aasanchez/Trabajo-de-Grado/Eagle/TG-Final/Diseño.png

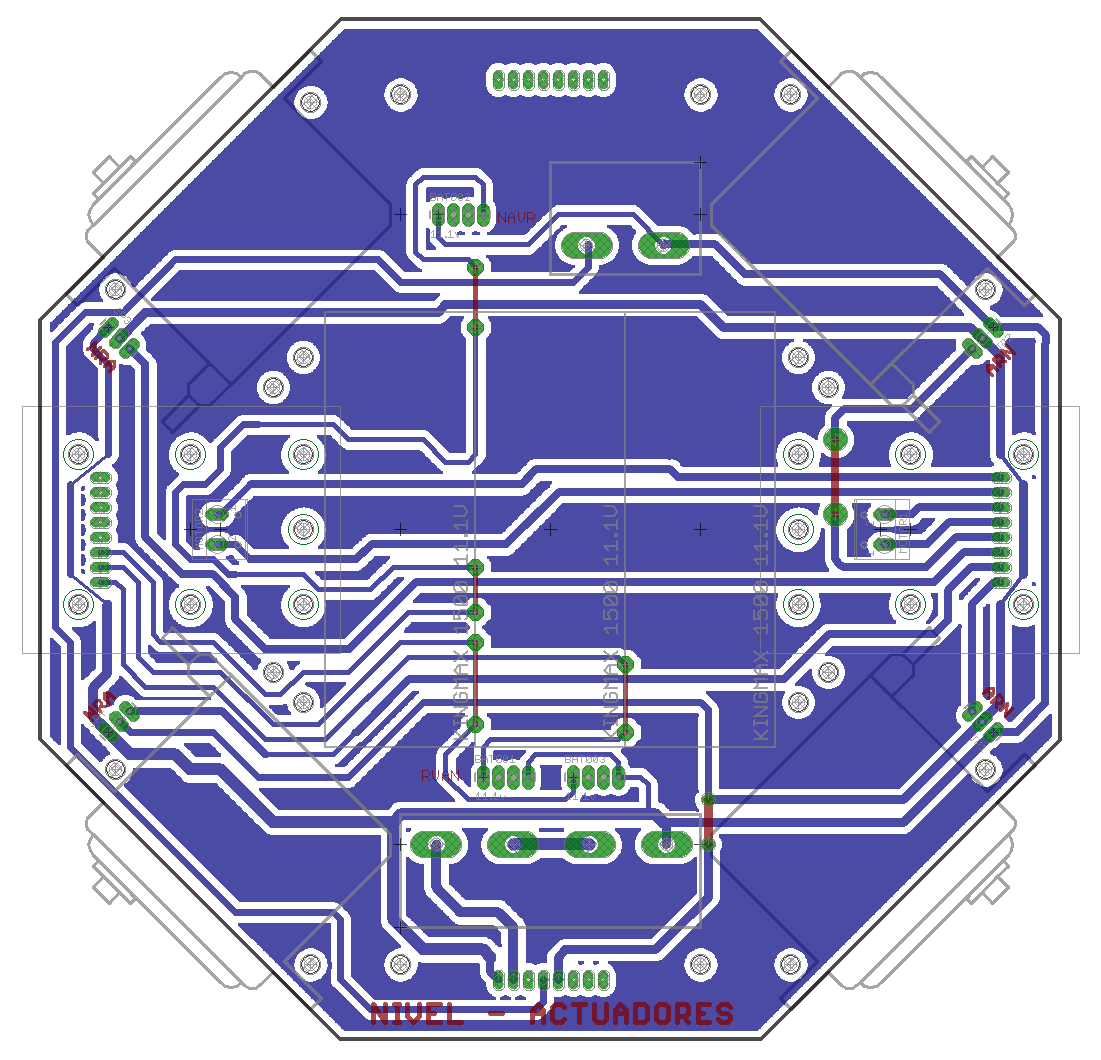
Eagle/TG-Final/Diseño.png
