aasanchez/Trabajo-de-Grado/Libro/Diagramas/Diagrama de Procesos.png

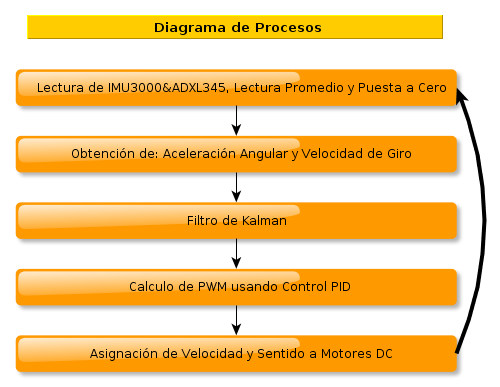
Libro/Diagramas/Diagrama de Procesos.png
