aasanchez/Trabajo-de-Grado/Libro/Diagramas/Procesos-002 (Adquisicion, puesta a 0 y calculo de Angulo).png

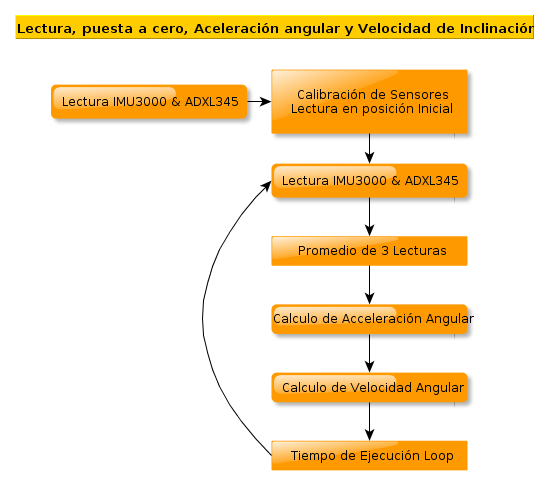
Libro/Diagramas/Procesos-002 (Adquisicion, puesta a 0 y calculo de Angulo).png
