aasanchez/Trabajo-de-Grado/Libro/RevisionDocumental/acceleraciones.png

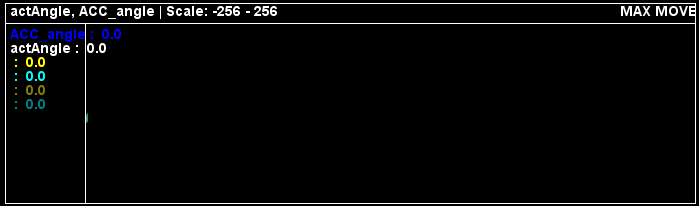
Libro/RevisionDocumental/acceleraciones.png
