aasanchez/Trabajo-de-Grado/Libro/RevisionDocumental/error.png

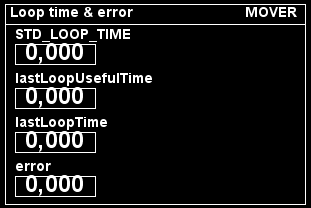
Libro/RevisionDocumental/error.png
