aasanchez/Trabajo-de-Grado/Libro/RevisionDocumental/graficadorusb.png

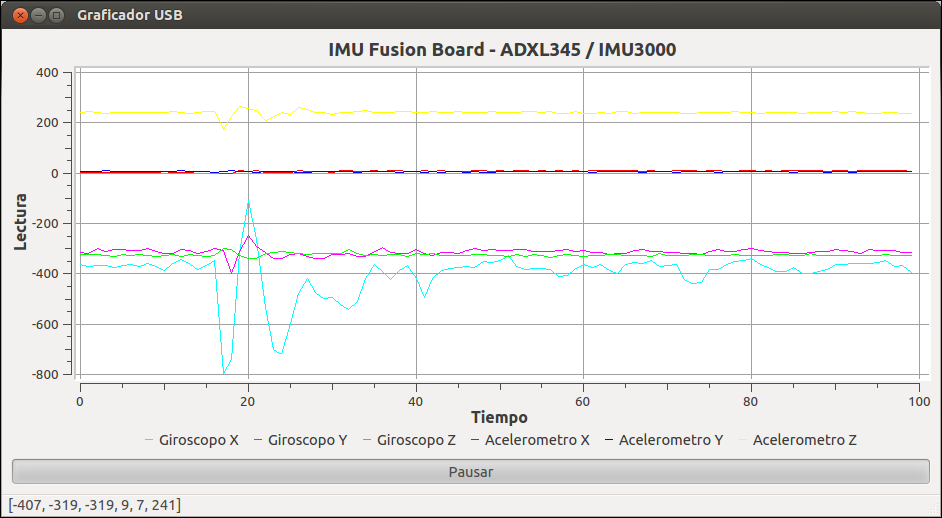
Libro/RevisionDocumental/graficadorusb.png
