aasanchez/Trabajo-de-Grado/Libro/RevisionDocumental/Gyroscope-9-4.png

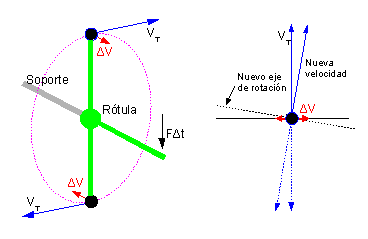
Libro/RevisionDocumental/Gyroscope-9-4.png
