aasanchez/Trabajo-de-Grado/Libro/RevisionDocumental/l298.bmp

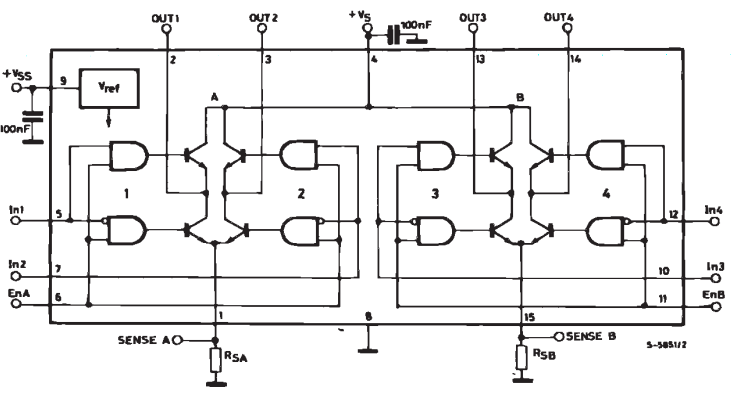
Libro/RevisionDocumental/l298.bmp
