aasanchez/Trabajo-de-Grado/Libro/RevisionDocumental/l298_pl.jpg

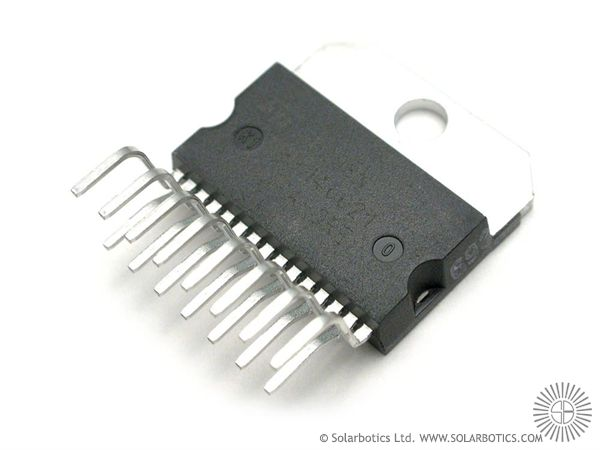
Libro/RevisionDocumental/l298_pl.jpg
