aasanchez/Trabajo-de-Grado/Libro/RevisionDocumental/lectura IMU.png

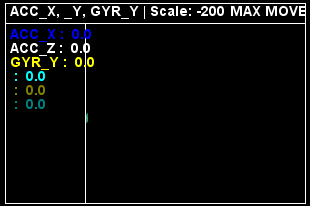
Libro/RevisionDocumental/lectura IMU.png
