aasanchez/Trabajo-de-Grado/Libro/RevisionDocumental/motores.png

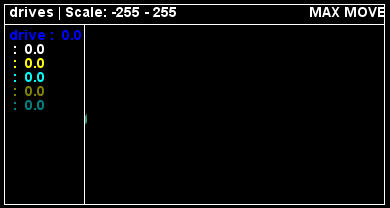
Libro/RevisionDocumental/motores.png
