aasanchez/Trabajo-de-Grado/Libro/RevisionDocumental/pid.png

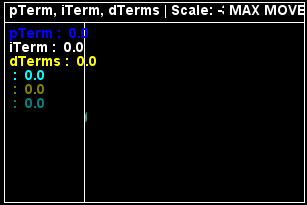
Libro/RevisionDocumental/pid.png
