aasanchez/Trabajo-de-Grado/Pruebas/lipomonitor/main.rtf

Software Development Document

for

%PROJECTTITLE%

Prepared by: %DEVELOPER%

%COMPANY%

Table of Contents

1.Scope
1.1 Identification
The formal name for this project is: %PROJECTTITLE%
The electronic name is: main
Date when project was created:%DATE_CREATED%
Dates when changes were made: %CHANGES%

1.2 Purpose
%PURPOSE%
1.3 Introduction
This document describes the detailed design for this project.

2. Referenced Documents
2.1 Related Documentation
%REFERENCES%

2.2 Project Source Files

main.c
..\..\..\..\Program Files\PICC\devices\16F88.H

2.3 Project Output File
main.err
main.esym
main.hex
main.sym
main.lst
main.cof
main.PJT
main.tre
main.sta

3. Requirements
3.1 Program Overview
%OVERVIEW%

3.2 Global Data
3.2.1 Constants

Identifier | Type | Description
__PCM__ | 4.114
__DEVICE__ | 88
__DATE__ | 15-feb-12
__TIME__ | 15:51:11 | Standard Header file for the PIC16F88 device ////////////////

3.2.2 Types
Identifier | Type | Description

3.2.3 Variables

Identifier | Type | Description
valor | int8

3.3 Detailed Design

3.3.1 main
3.3.1.1 Requirements

Author: %AUTHOR%
Purpose: %PURPOSE%
Date Created:%DATE_CREATED%
Changes:%CHANGES%

3.3.1.2 Local Data

Identifier | Type | Description

3.3.1.3 Local Constants

Identifier | Type | Description

3.3.1.4 Local Types

Identifier | Type | Description

4.0 Functions

Function Name | Description
main
