aasanchez/Trabajo-de-Grado/Libro/pruebas/Aceleracion Angular.png

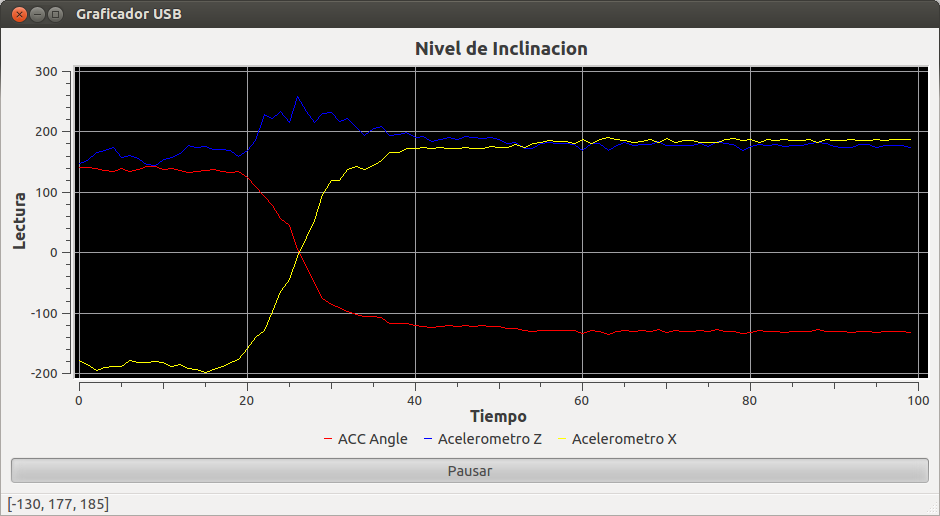
Libro/pruebas/Aceleracion Angular.png
