aasanchez/Trabajo-de-Grado/Libro/pruebas/tip42.png

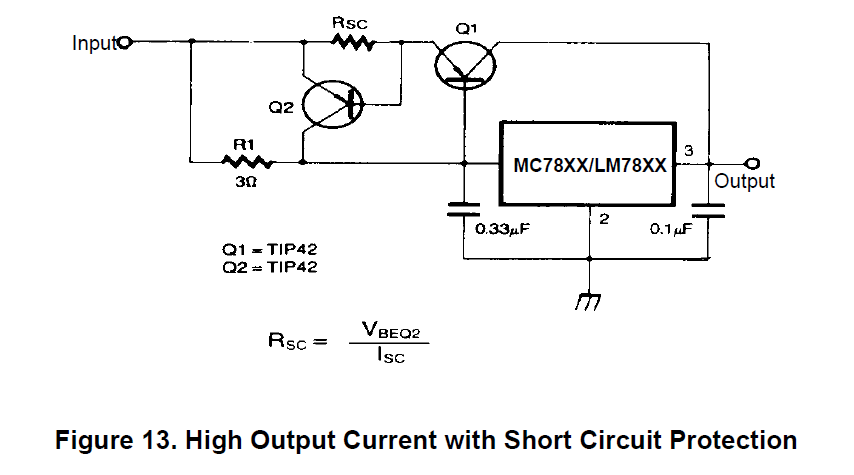
Libro/pruebas/tip42.png
