aasanchez/Trabajo-de-Grado/Pruebas/Imagenes de Apoyo/7805_a_5amp_212.jpg

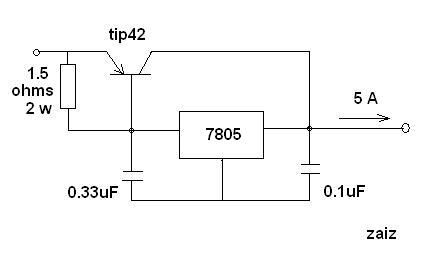
Pruebas/Imagenes de Apoyo/7805_a_5amp_212.jpg
