aasanchez/Trabajo-de-Grado/Pruebas/Imagenes de Apoyo/fuente_5v_848.gif

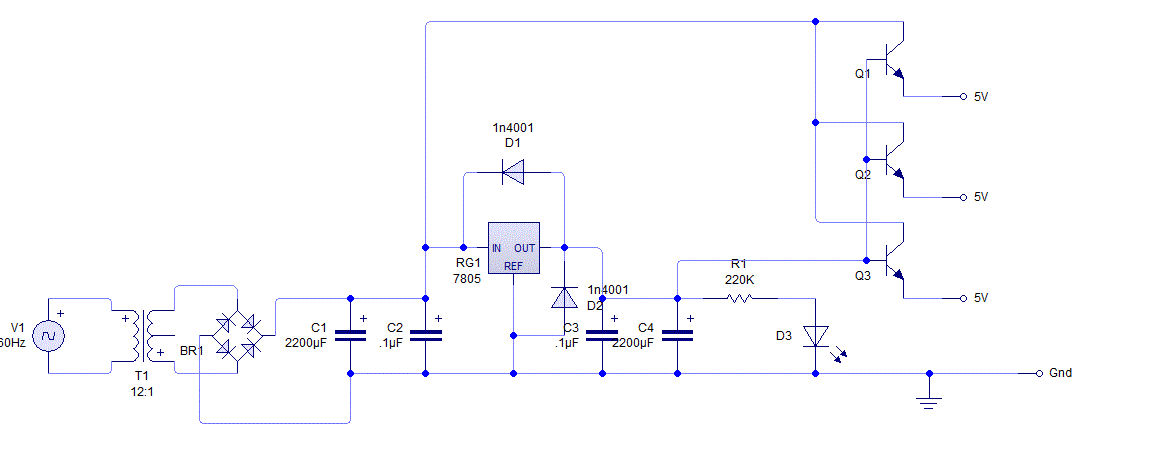
Pruebas/Imagenes de Apoyo/fuente_5v_848.gif
