aasanchez/Trabajo-de-Grado/Pruebas/Imagenes de Apoyo/fuente_5v_version2_129.gif

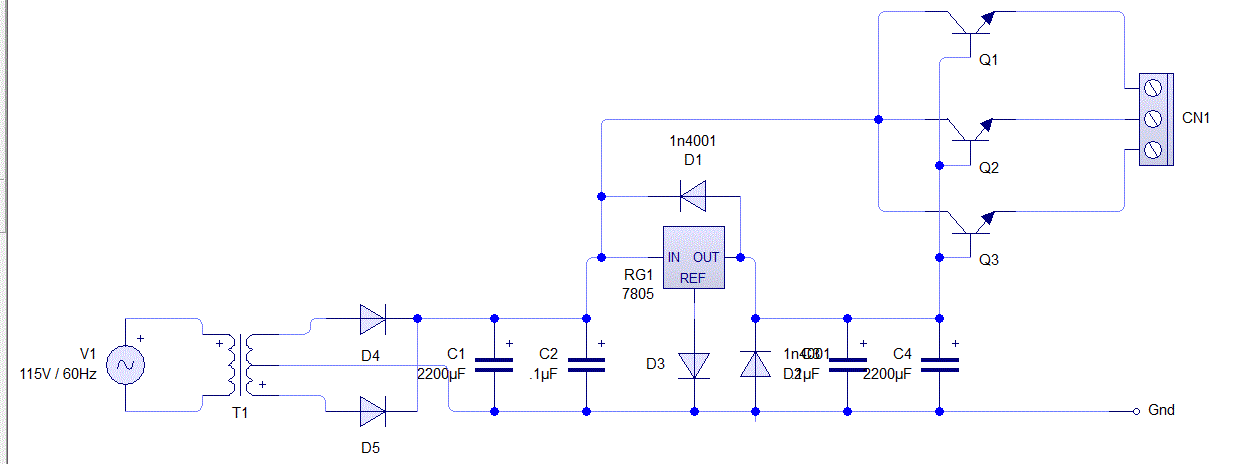
Pruebas/Imagenes de Apoyo/fuente_5v_version2_129.gif
