aasanchez/Trabajo-de-Grado/Pruebas/Imagenes de Apoyo/regulador1_195.pdf

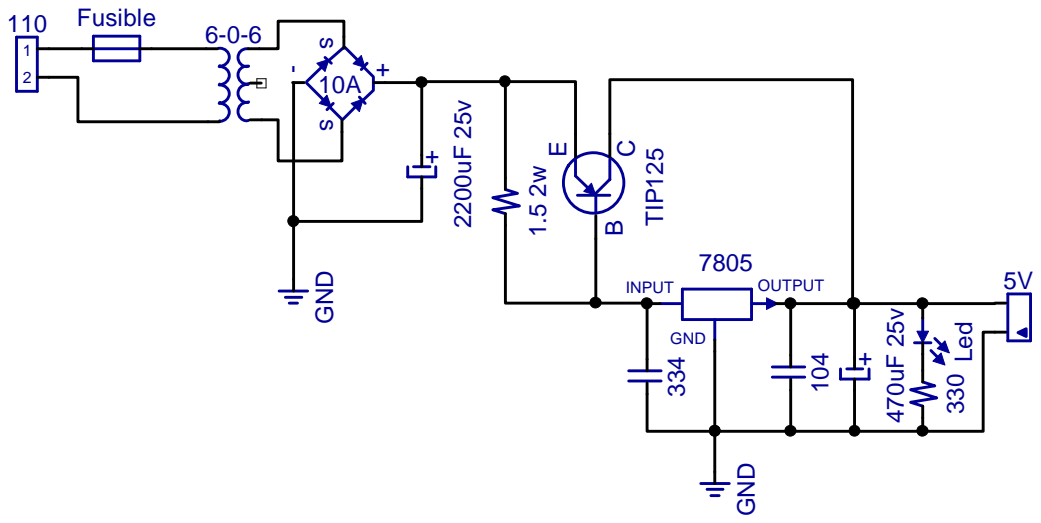
[picture p71: page 1]
GND; Fusible; Led; TIP125; INPUT; OUTPUT
