aasanchez/Trabajo-de-Grado/Eagle/TG-Final/bluesmirf.pdf

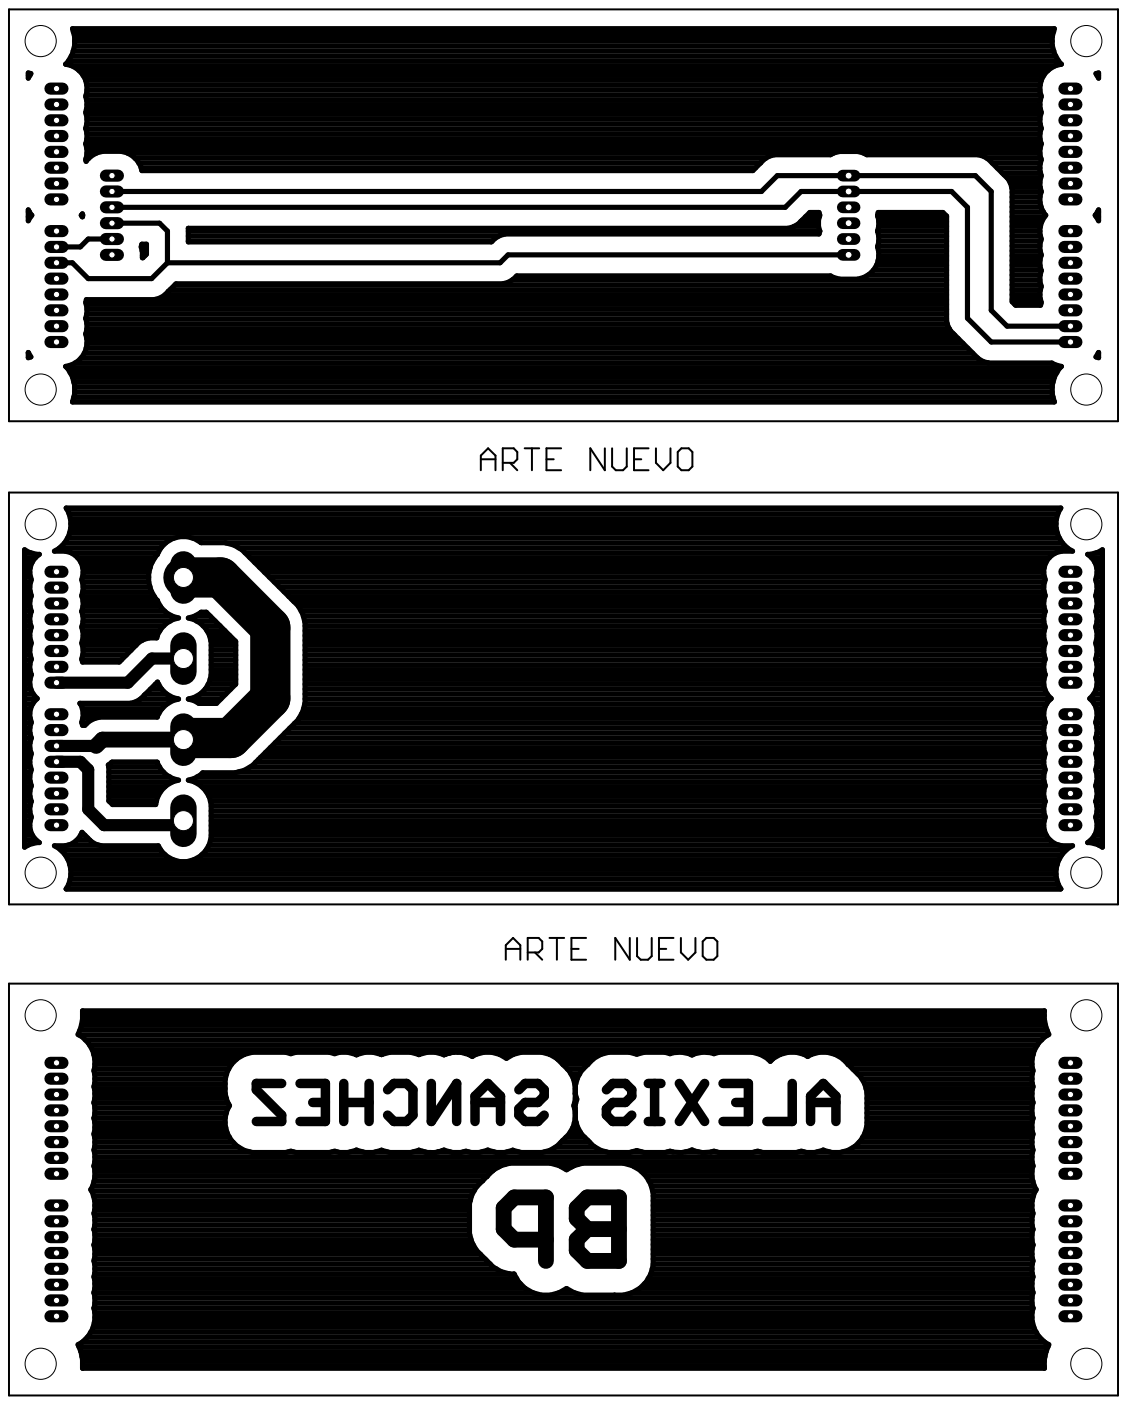
[picture p72: page 1]
