aasanchez/Trabajo-de-Grado/Eagle/TG-Final/control-silkcreen.pdf

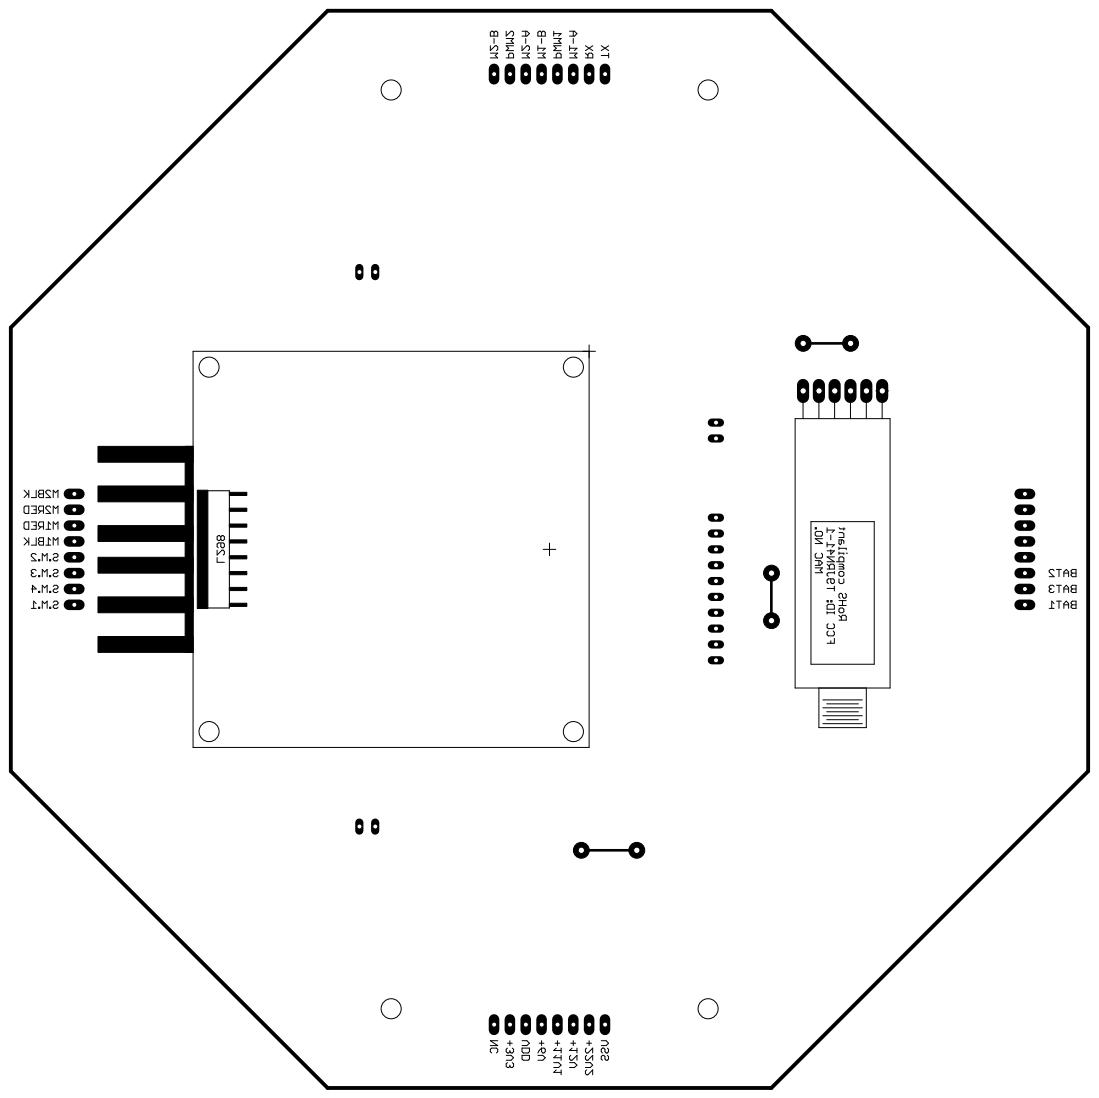
[picture p73: page 1]
