aasanchez/Trabajo-de-Grado/Eagle/TG-Final/energia.pdf

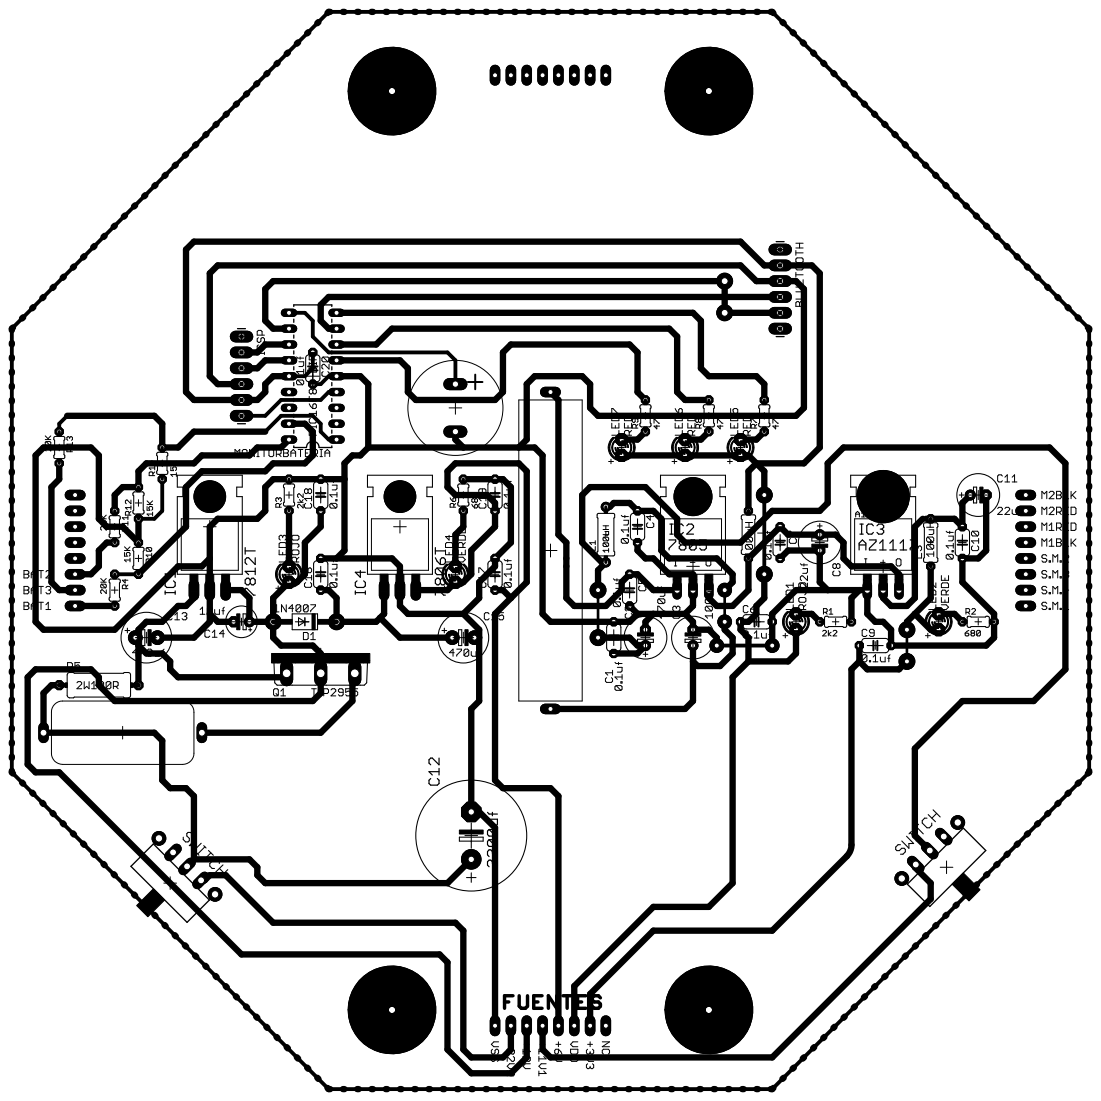
[picture p74: page 1]
