aasanchez/Trabajo-de-Grado/Eagle/TG-Final/nivel0.pdf

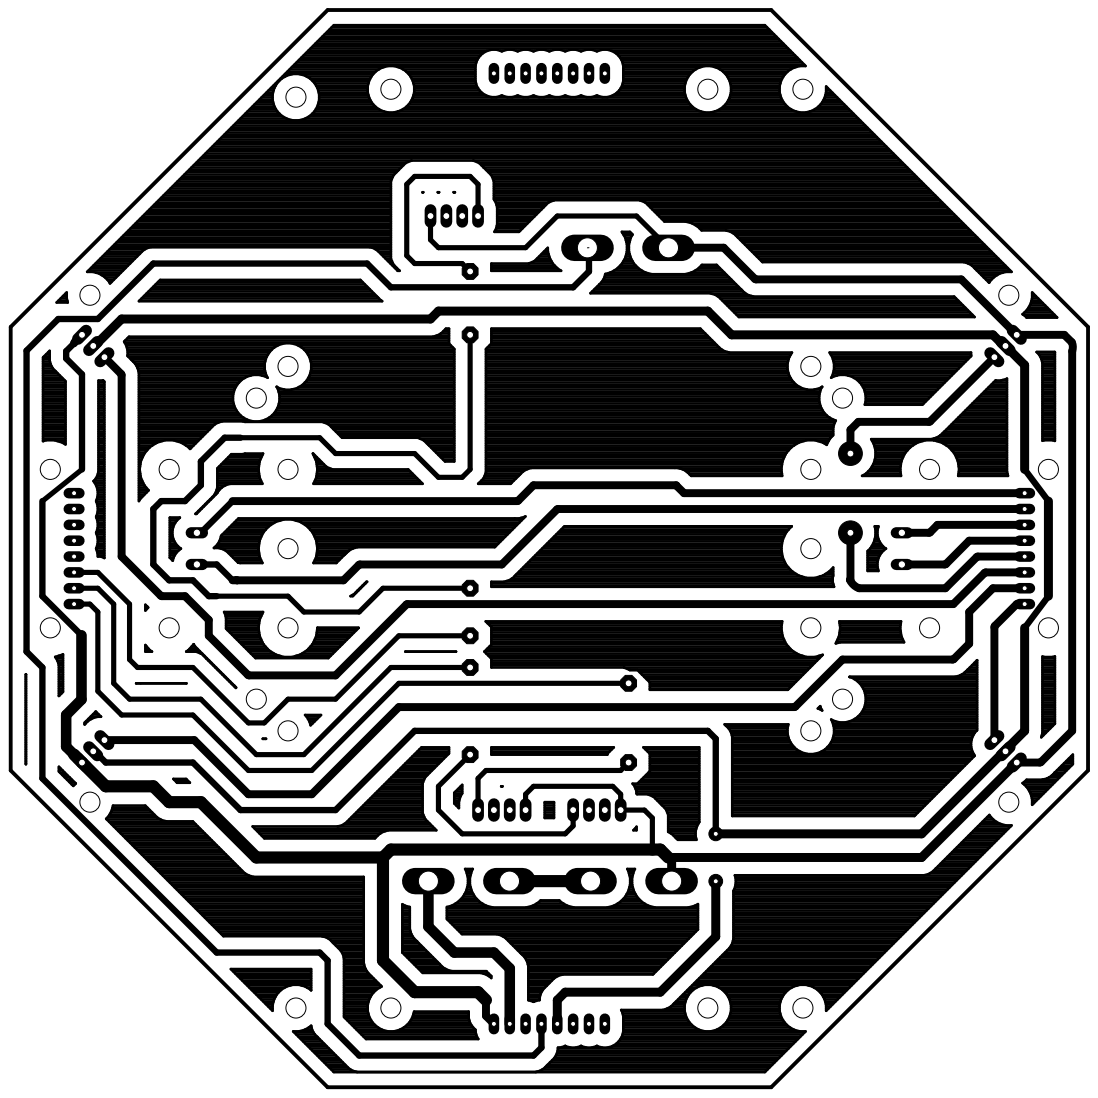
[picture p75: page 1]
