aasanchez/Trabajo-de-Grado/Eagle/TG-Final/nivel0-silkcreen.pdf

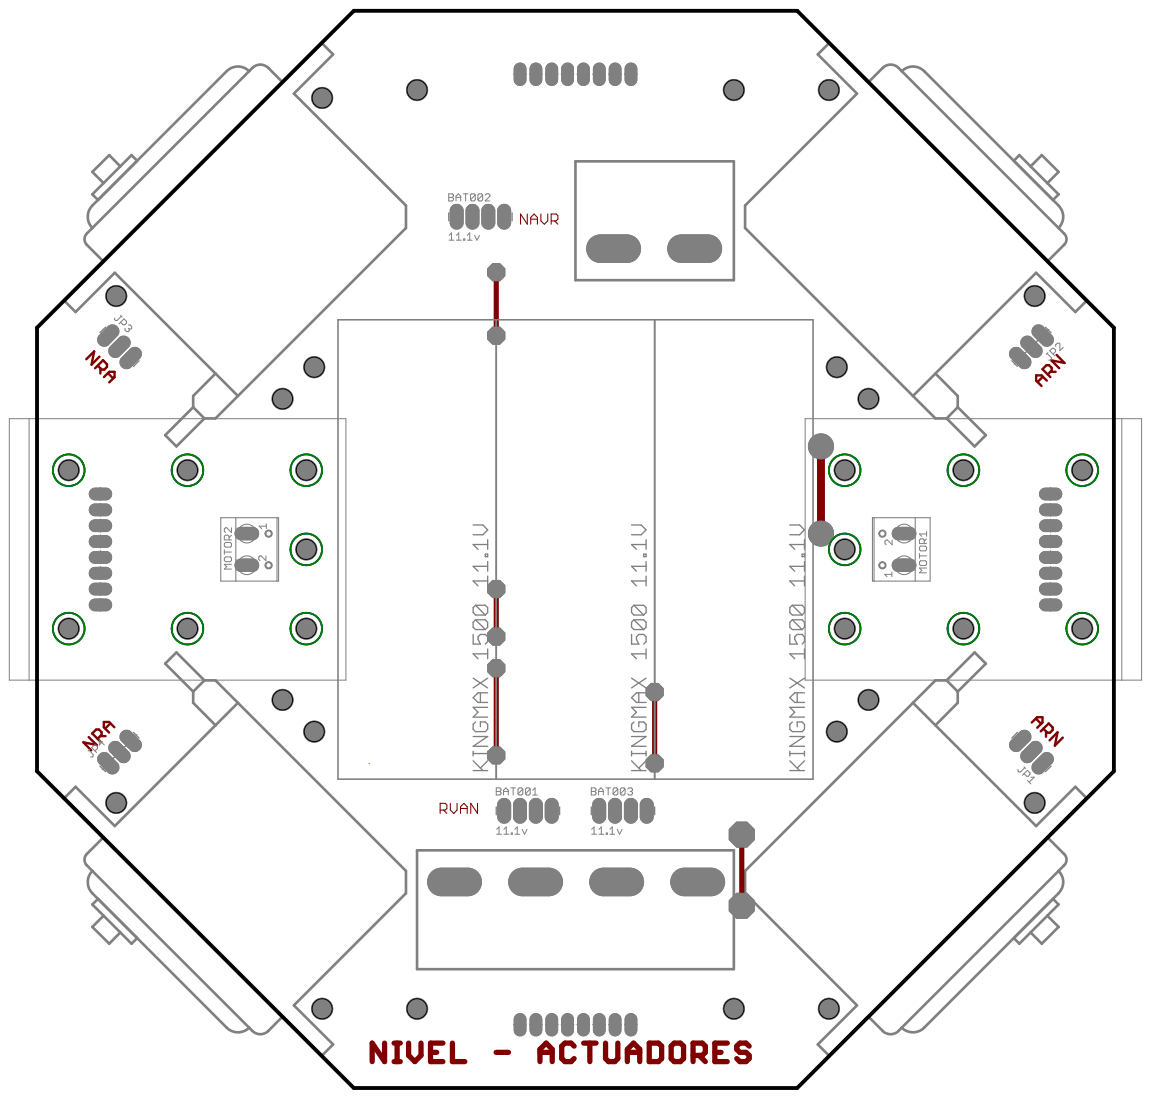
[picture p76: page 1]
