aasanchez/Trabajo-de-Grado/(list of files, drawings)

Other design files:
Libro/Diagramas/Esquematico.fzz
Pruebas/16f88/simulador.DSN
Pruebas/Barrido leds/simulador.DSN
Pruebas/lipomonitor/simulador.DSN
