aasanchez/Trabajo-de-Grado/Eagle/TG-Final/Motores.brd

## EAGLE design Eagle/TG-Final/Motores.brd (2012-04-23)

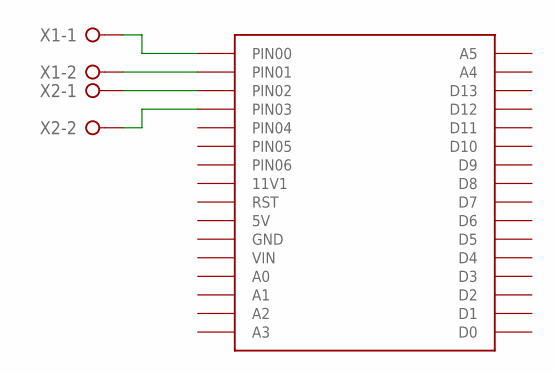
[picture p77: schematic Motores.sch]

Parts:
U$1: BASE-FINAL
X1, X2: W237-02P; W237-132

Connections:
unnamed: U$1.PIN01, X1.2
unnamed: U$1.PIN02, X2.1
unnamed: U$1.PIN03, X2.2
unnamed: U$1.PIN00, X1.1

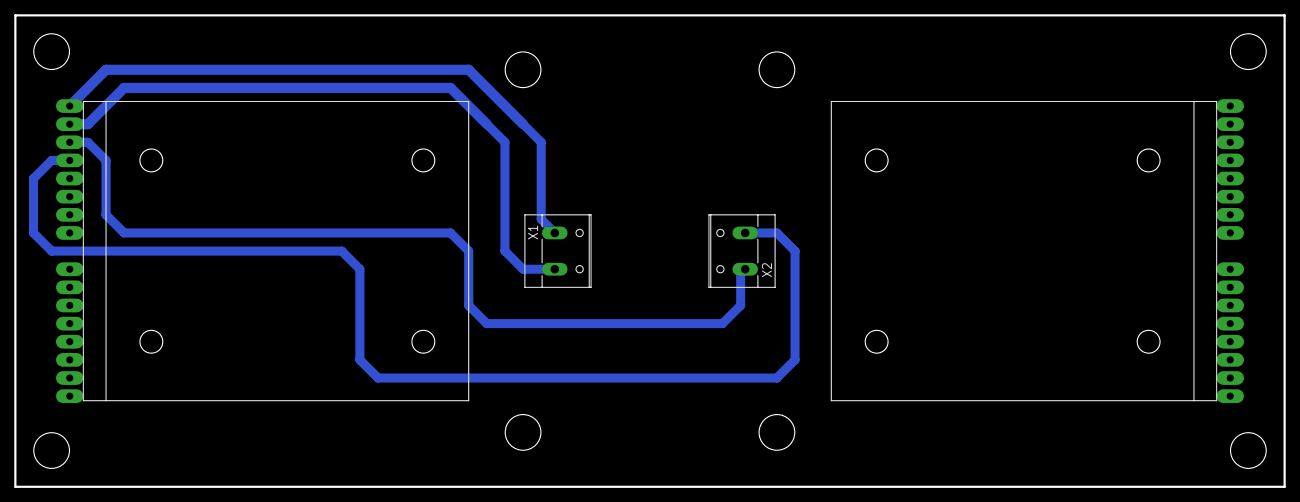
[picture p78: board Motores.brd from above]

Board: 2 copper layers, 177.8 x 66.0 mm, 5 parts (0 on the bottom side), 4 nets.

Other parts of the board:
U$2, U$3: BASEMOTOR
