aasanchez/Trabajo-de-Grado/Eagle/TG-Final/arduino.brd

## EAGLE design Eagle/TG-Final/arduino.brd (2012-04-23)

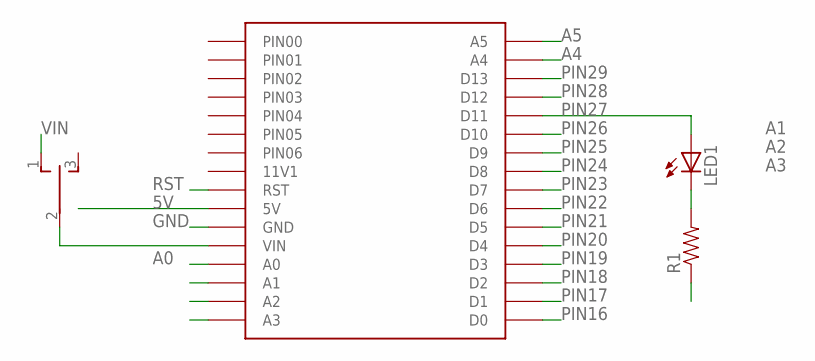
[picture p79: schematic arduino.sch, sheet 1]

Parts:
LED1: LED3MM
R1: RESISTORKIT; AXIAL-0.3-KIT
S2: TL39YOSWITCH_2_ESTADOS; TL3XYO
U$1: BASE-FINAL

Connections:
5V: U$1.5V; also elsewhere on the board
A0: U$1.A0; also elsewhere on the board
A1: U$1.A1; also elsewhere on the board
A2: U$1.A2; also elsewhere on the board
A3: U$1.A3; also elsewhere on the board
A4: U$1.A4; also elsewhere on the board
A5: U$1.A5; also elsewhere on the board
GND: R1.P$1 (1), U$1.GND; also elsewhere on the board
unnamed: S2.2, U$1.VIN
unnamed: LED1.K (C), R1.P$2 (2)
PIN16: U$1.0 (D0); also elsewhere on the board
PIN17: U$1.1 (D1); also elsewhere on the board
PIN18: U$1.2 (D2); also elsewhere on the board
PIN19: U$1.3 (D3); also elsewhere on the board
PIN20: U$1.4 (D4); also elsewhere on the board
PIN21: U$1.5 (D5); also elsewhere on the board
PIN22: U$1.6 (D6); also elsewhere on the board
PIN23: U$1.7 (D7); also elsewhere on the board
PIN24: U$1.8 (D8); also elsewhere on the board
PIN25: U$1.9 (D9); also elsewhere on the board
PIN26: U$1.10 (D10); also elsewhere on the board
PIN27: LED1.A, U$1.11 (D11); also elsewhere on the board
PIN28: U$1.12 (D12); also elsewhere on the board
PIN29: U$1.13 (D13); also elsewhere on the board
RST: U$1.RST; also elsewhere on the board
VIN: S2.1 (O); also elsewhere on the board

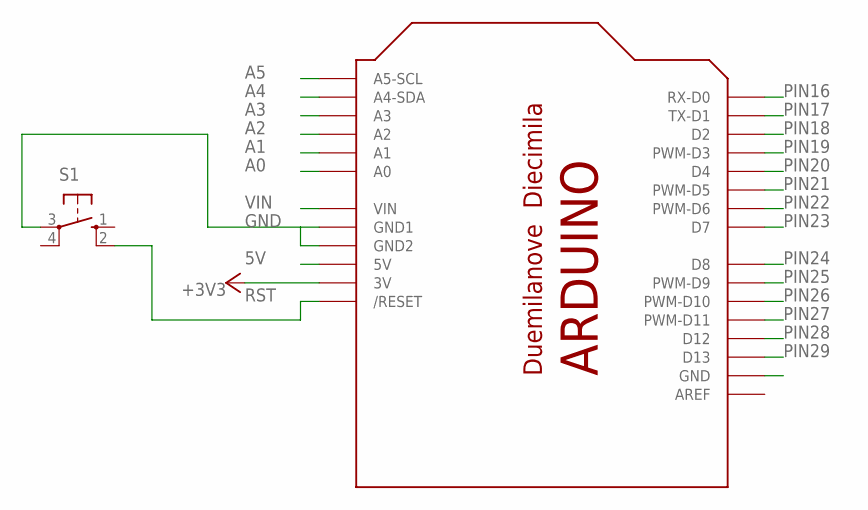
[picture p80: schematic arduino.sch, sheet 2]

Parts:
S1: 10-XX; B3F-10XX
U$6: ARDUINO-NOHOLE

Connections:
5V: U$6.5V; also elsewhere on the board
+3V3: U$6.3V; also elsewhere on the board
A0: U$6.A0; also elsewhere on the board
A1: U$6.A1; also elsewhere on the board
A2: U$6.A2; also elsewhere on the board
A3: U$6.A3; also elsewhere on the board
A4: U$6.A4 (A4-SDA); also elsewhere on the board
A5: U$6.A5 (A5-SCL); also elsewhere on the board
GND: S1.3, U$6.GND, U$6.GND1, U$6.GND2; also elsewhere on the board
PIN16: U$6.D0 (RX-D0); also elsewhere on the board
PIN17: U$6.D1 (TX-D1); also elsewhere on the board
PIN18: U$6.D2; also elsewhere on the board
PIN19: U$6.D3 (PWM-D3); also elsewhere on the board
PIN20: U$6.D4; also elsewhere on the board
PIN21: U$6.D5 (PWM-D5); also elsewhere on the board
PIN22: U$6.D6 (PWM-D6); also elsewhere on the board
PIN23: U$6.D7; also elsewhere on the board
PIN24: U$6.D8; also elsewhere on the board
PIN25: U$6.D9 (PWM-D9); also elsewhere on the board
PIN26: U$6.D10 (PWM-D10); also elsewhere on the board
PIN27: U$6.D11 (PWM-D11); also elsewhere on the board
PIN28: U$6.D12; also elsewhere on the board
PIN29: U$6.D13; also elsewhere on the board
RST: S1.2 (S1), U$6.RESET (/RESET); also elsewhere on the board
VIN: U$6.VIN; also elsewhere on the board

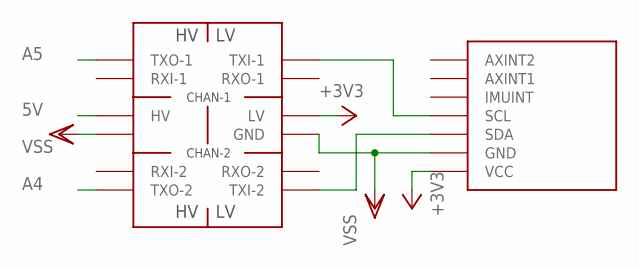
[picture p81: schematic arduino.sch, sheet 3]

Parts:
U$7: IMU3000COMBO; IMU3000-COMBO
U$8: LOGIC-LEVEL-CONVERTER; LEVEL-CONVERTER

Connections:
5V: U$8.P$10 (HV); also elsewhere on the board
+3V3: U$7.3V3 (VCC), U$8.P$3 (LV); also elsewhere on the board
A4: U$8.P$7 (TXO-2); also elsewhere on the board
A5: U$8.P$12 (TXO-1); also elsewhere on the board
GND: U$7.VSS (GND), U$8.P$4 (GND), U$8.P$9; also elsewhere on the board
unnamed: U$7.SCL, U$8.P$1 (TXI-1)
unnamed: U$7.SDA, U$8.P$6 (TXI-2)

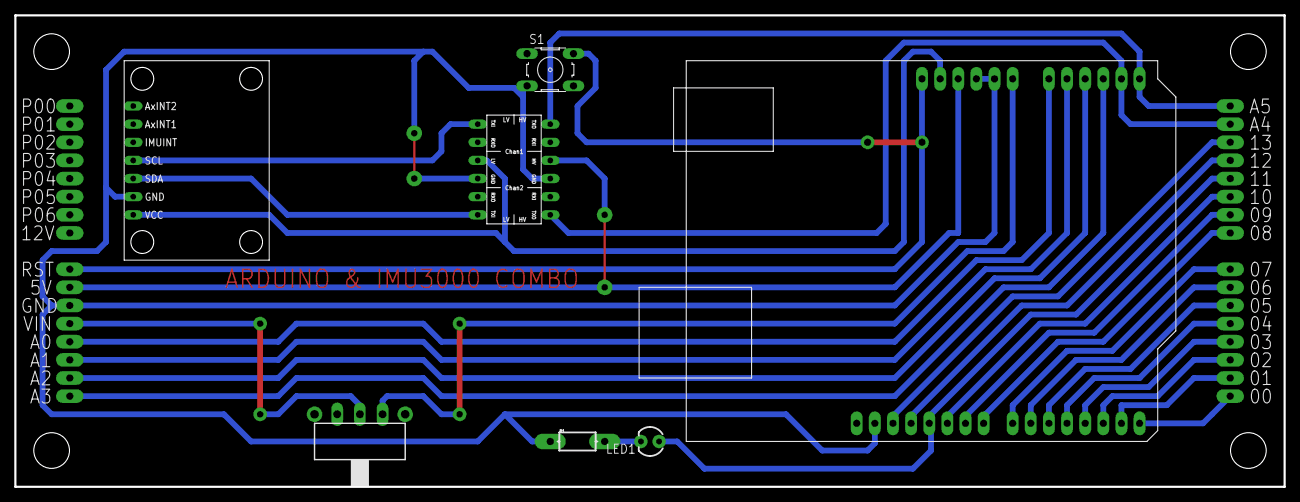
[picture p82: board arduino.brd from above]

Board: 2 copper layers, 177.8 x 66.0 mm, 8 parts (1 on the bottom side), 29 nets.
