aasanchez/Trabajo-de-Grado/Eagle/TG-Final/bluesmirf.brd

## EAGLE design Eagle/TG-Final/bluesmirf.brd (2012-04-23)

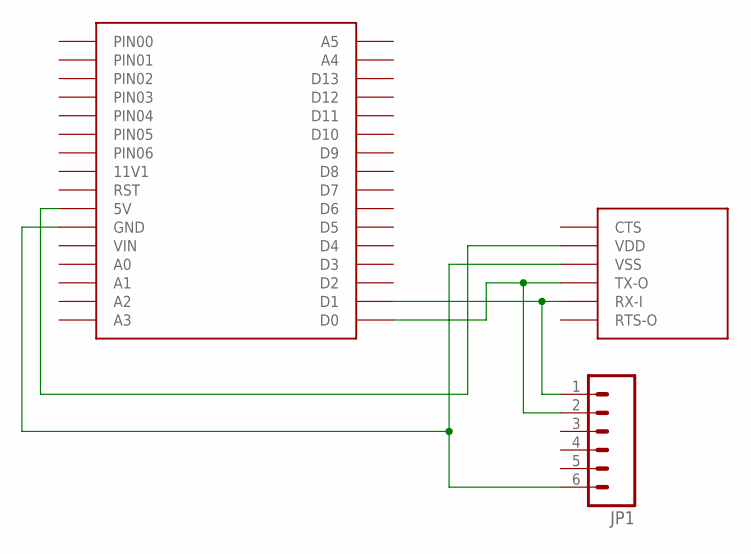
[picture p83: schematic bluesmirf.sch, sheet 1]

Parts:
JP1: M06LONGPADS; 1X06_LONGPADS
U$1: BASE-FINAL
U$2: BLUESMIRF

Connections:
unnamed: U$1.5V, U$2.VDD
unnamed: JP1.6, U$1.GND, U$2.VSS
unnamed: JP1.2, U$1.0 (D0), U$2.TX-O
unnamed: JP1.1, U$1.1 (D1), U$2.RX-I

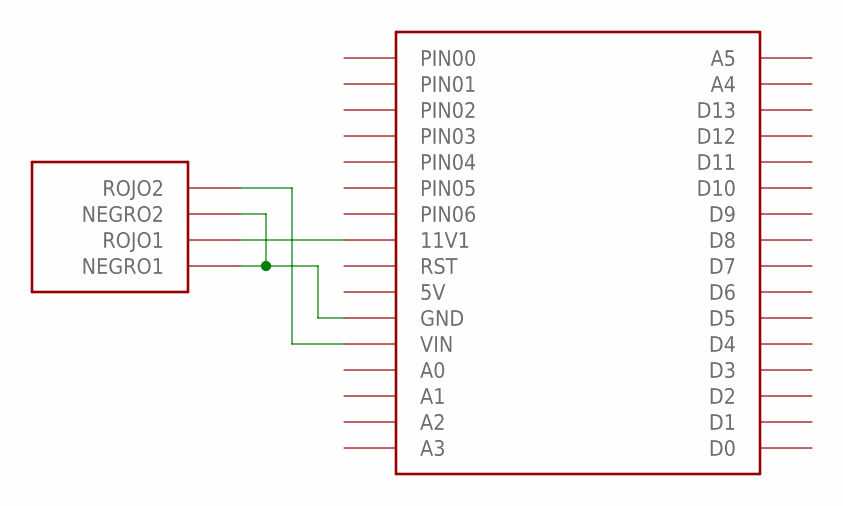
[picture p84: schematic bluesmirf.sch, sheet 2]

Parts:
U$3: BASE-FINAL
U$4: CONECTOR_AUDIO

Connections:
unnamed: U$3.GND, U$4.NEGRO1, U$4.NEGRO2
unnamed: U$3.12V (11V1), U$4.ROJO1
unnamed: U$3.VIN, U$4.ROJO2

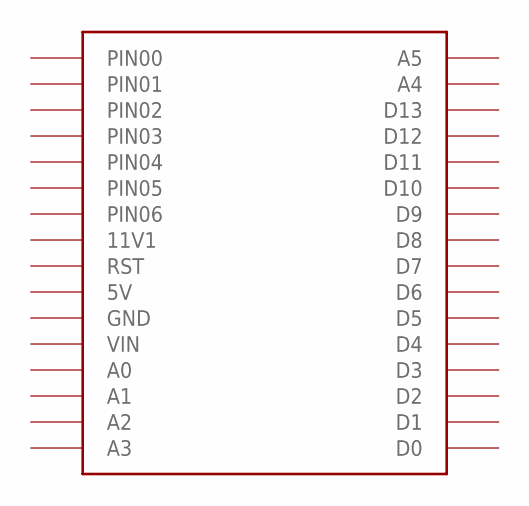
[picture p85: schematic bluesmirf.sch, sheet 3]

Parts:
U$7: BASE-FINAL

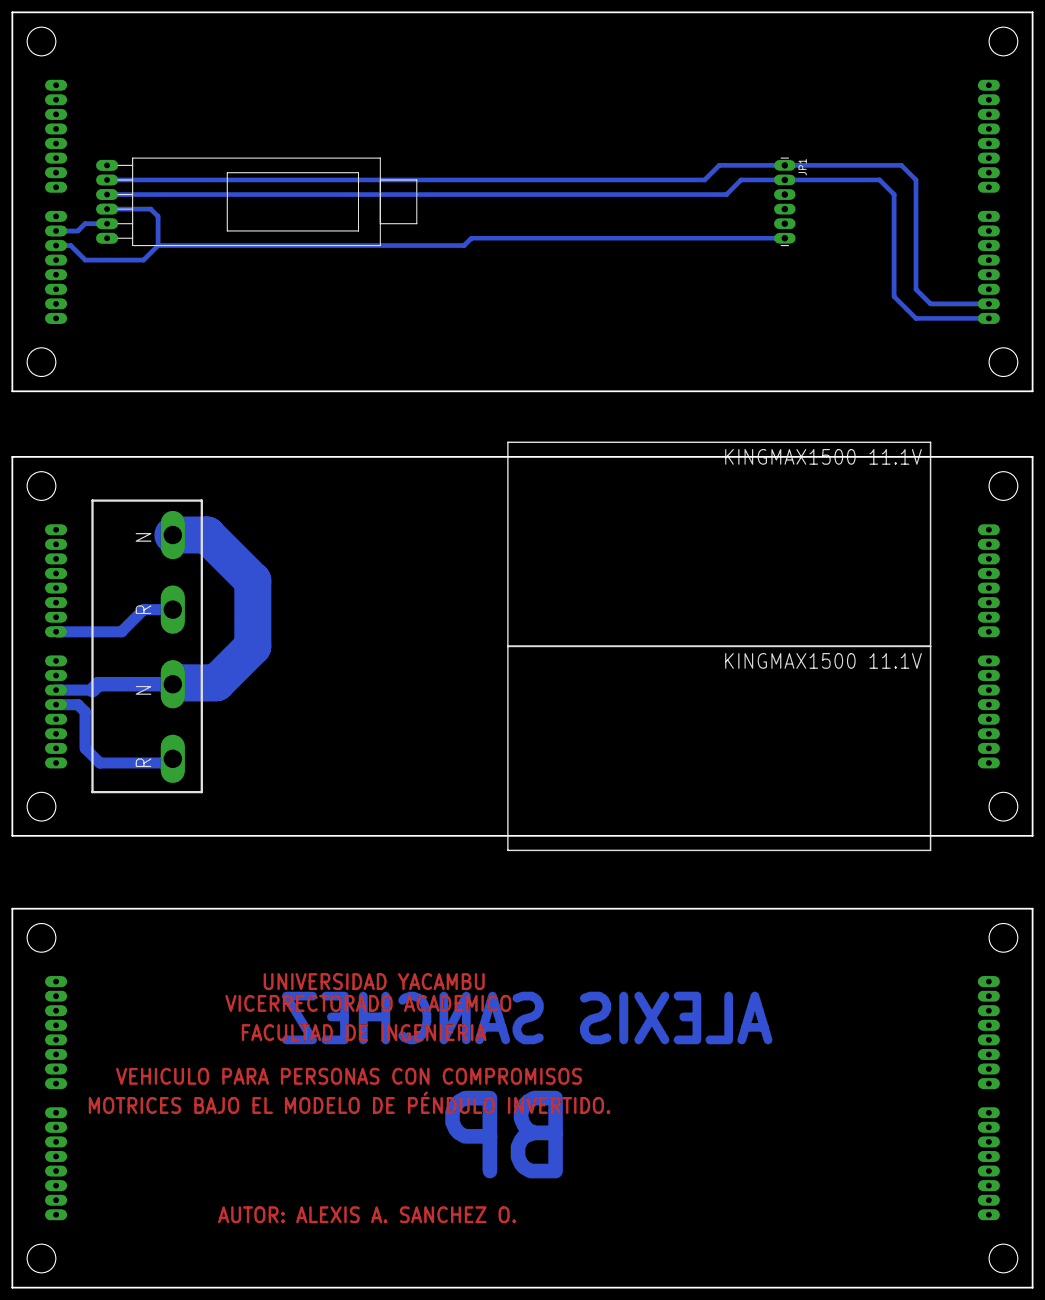
[picture p86: board bluesmirf.brd from above]

Board: 2 copper layers, 177.8 x 222.2 mm, 8 parts (0 on the bottom side), 7 nets.

Other parts of the board:
U$5, U$6: KINGMAX1500H
