aasanchez/Trabajo-de-Grado/Eagle/TG-Final/brain.brd

## EAGLE design Eagle/TG-Final/brain.brd (2012-04-15)

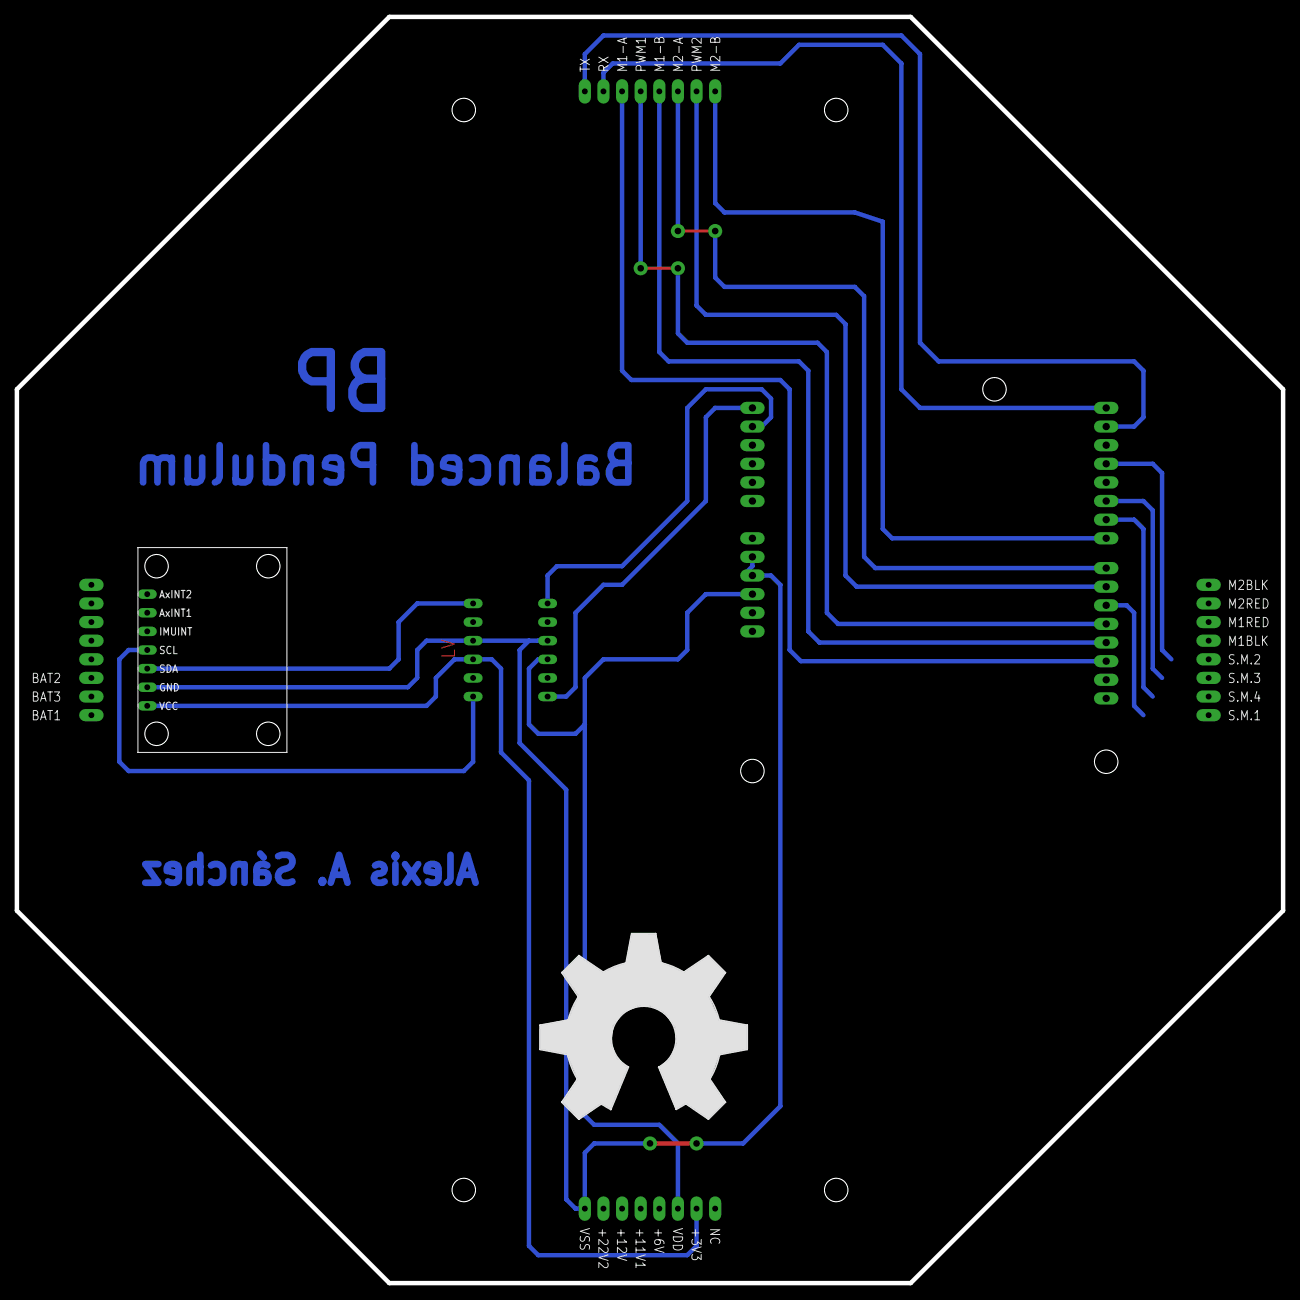
[picture p87: board brain.brd from above]

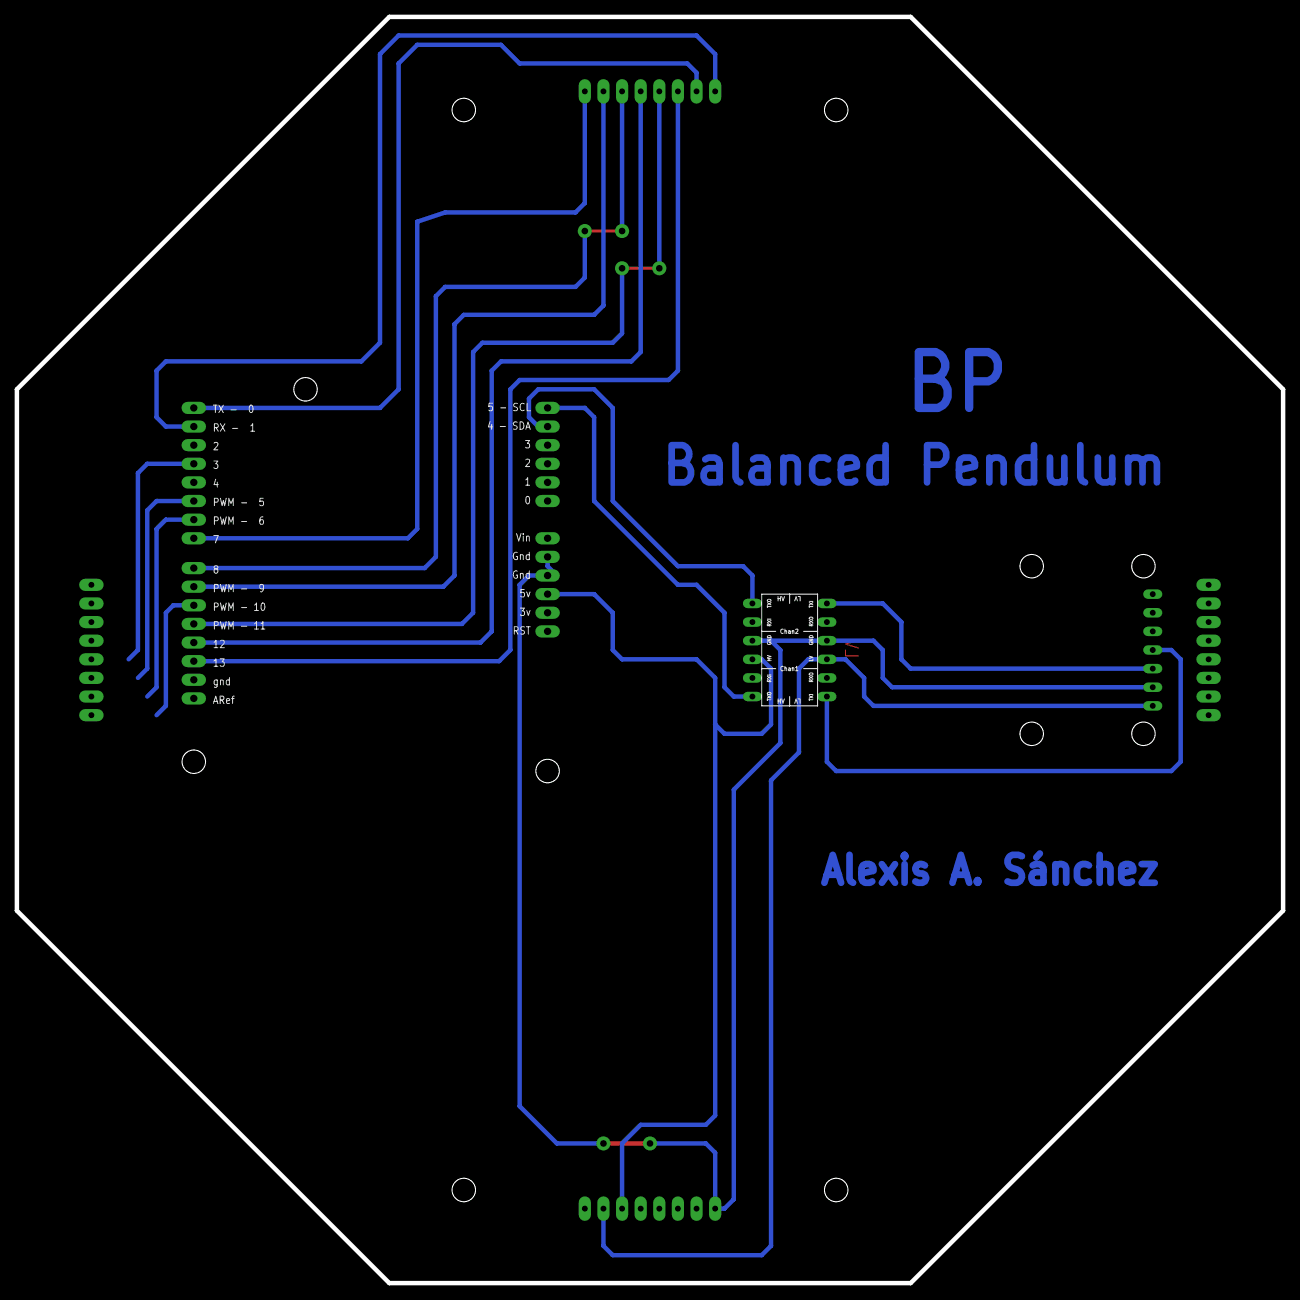
[picture p88: board brain.brd from below]

Board: 2 copper layers, 172.7 x 172.7 mm, 5 parts (2 on the bottom side), 15 nets.

Parts:
U$1: BASE
U$3: OSHW_FILLX1000_NOTEXT
U$6: ARDUINOUNO; ARDUINO
U$7: IMU3000COMBO; IMU3000-COMBO
U$8: LOGIC-LEVEL-CONVERTER; LEVEL-CONVERTER

Connections:
+3V3: U$1.PIN22, U$7.3V3, U$8.P$3
M1-A: U$1.PIN05, U$6.D13
M1-B: U$1.PIN03, U$6.D12
M2-A: U$1.PIN02, U$6.D8
M2-B: U$1.PIN00, U$6.D7
unnamed: U$7.SCL, U$8.P$1
unnamed: U$7.SDA, U$8.P$6
PWM1: U$1.PIN04, U$6.D11
PWM2: U$1.PIN01, U$6.D9
RX: U$1.PIN06, U$6.D0
SCL: U$6.A5, U$8.P$12
SDA: U$6.A4, U$8.P$7
TX: U$1.PIN07, U$6.D1
VDD: U$1.PIN21, U$6.5V, U$8.P$10
VSS: U$1.PIN16, U$6.GND1, U$6.GND2, U$7.VSS, U$8.P$4, U$8.P$9
