aasanchez/Trabajo-de-Grado/Eagle/TG-Final/energia-2.brd

## EAGLE design Eagle/TG-Final/energia-2.brd (2012-04-06)

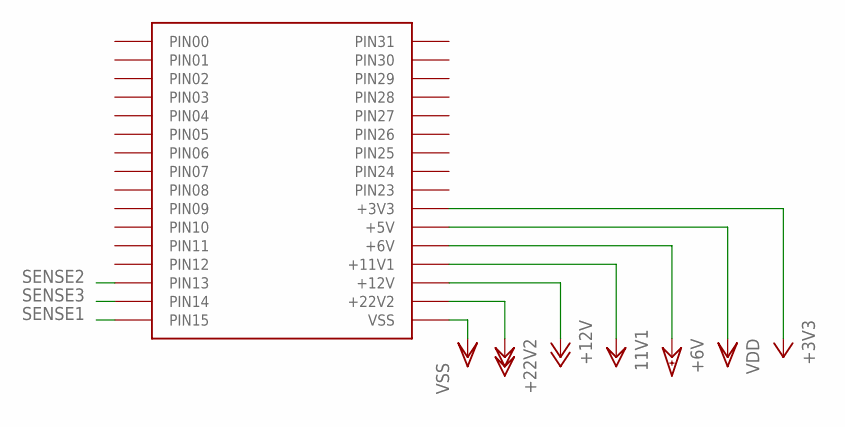
[picture p89: schematic energia-2.sch, sheet 1, Base]

Parts:
U$1: BASE

Connections:
+3V3: U$1.PIN22 (+3V3); also elsewhere on the board
+6V: U$1.PIN20 (+6V); also elsewhere on the board
+11V1: U$1.PIN19 (+11V1); also elsewhere on the board
+12V: U$1.PIN18 (+12V); also elsewhere on the board
+22V: U$1.PIN17 (+22V2); also elsewhere on the board
SENSE1: U$1.PIN15; also elsewhere on the board
SENSE2: U$1.PIN13; also elsewhere on the board
SENSE3: U$1.PIN14; also elsewhere on the board
VDD: U$1.PIN21 (+5V); also elsewhere on the board
VSS: U$1.PIN16 (VSS); also elsewhere on the board

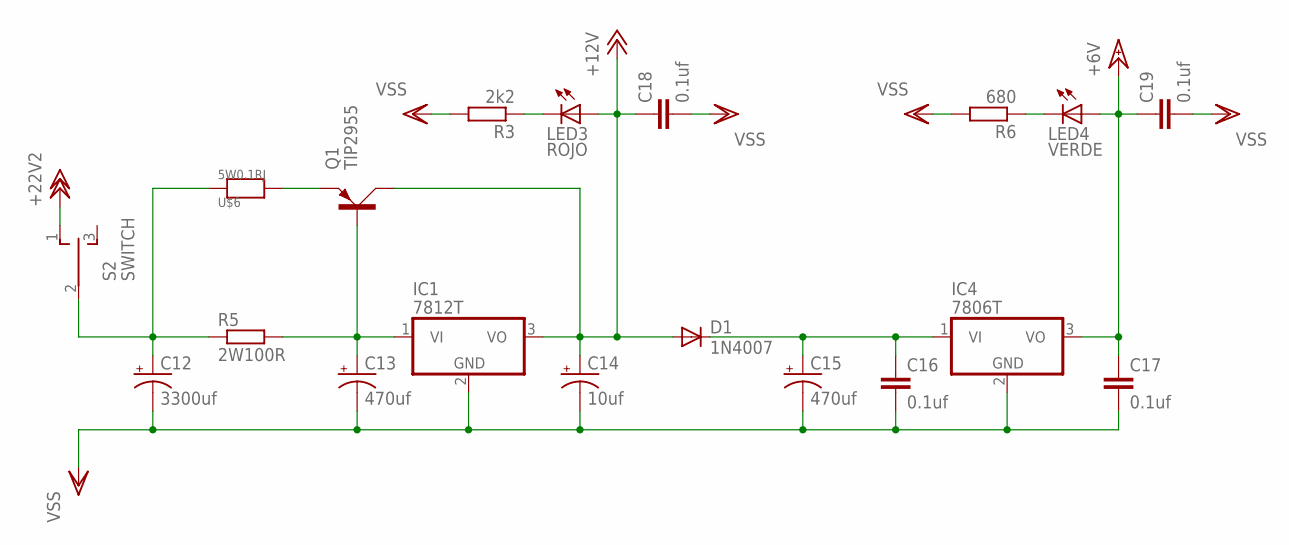
[picture p90: schematic energia-2.sch, sheet 2, Actuadores]

Parts:
C12: 3300uf; E7,5-18
C13, C15: 470uf; E3,5-8
C14: 10uf; E2,5-5
C16, C17, C18, C19: 0.1uf; C050-024X044
D1: 1N4007; DO41-10
IC1: 7812T; TO220H
IC4: 7806T; TO220H
LED3: ROJO; LED3MM
LED4: VERDE; LED3MM
Q1: TIP2955; TOP3AV
R3: 2k2; 0204/5
R5: 2W100R; 0411/12
R6: 680; 0204/5
S2: SWITCH; TL3XYO
U$6: 5W0.1RJ; RES-22X10

Connections:
+6V: C17.1, C19.1, IC4.3 (VO), LED4.A; also elsewhere on the board
+12V: C14.+, C18.1, D1.A, IC1.3 (VO), LED3.A, Q1.C; also elsewhere on the board
+22V: S2.1 (O); also elsewhere on the board
unnamed: LED3.K (C), R3.1
unnamed: C12.+, R5.1, S2.2, U$6.P$1
unnamed: Q1.E, U$6.P$2
unnamed: C13.+, IC1.1 (VI), Q1.B, R5.2
unnamed: LED4.K (C), R6.1
unnamed: C15.+, C16.1, D1.C, IC4.1 (VI)
VSS: C12.-, C13.-, C14.-, C15.-, C16.2, C17.2, C18.2, C19.2, IC1.2 (GND), IC4.2 (GND), R3.2, R6.2; also elsewhere on the board

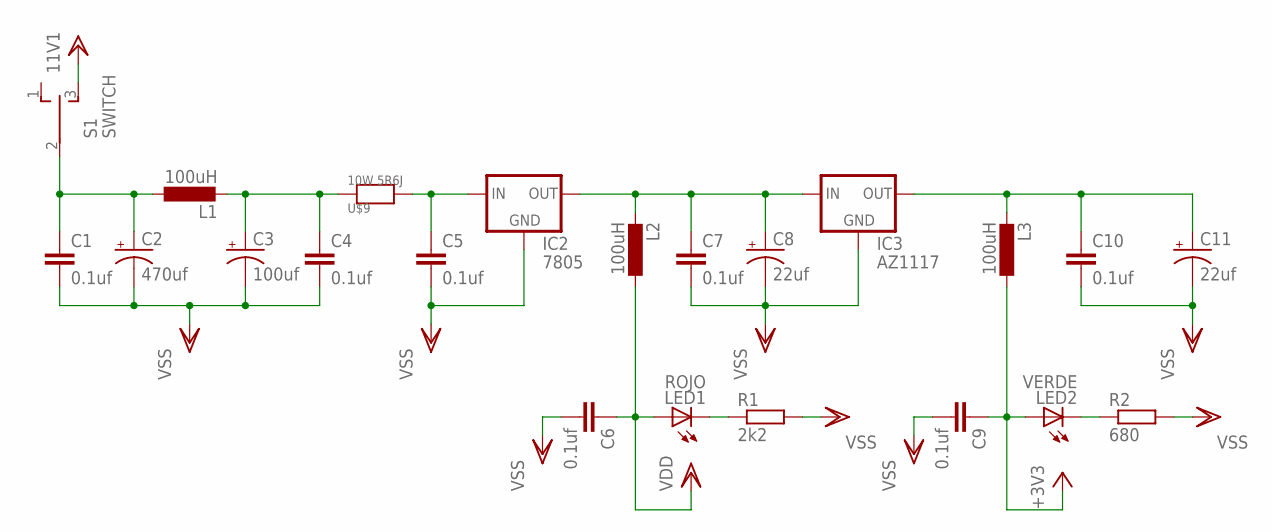
[picture p91: schematic energia-2.sch, sheet 3, Energia Nucleo]

Parts:
C1, C4, C5, C6, C7, C9, C10: 0.1uf; C050-024X044
C2: 470uf; E2,5-7
C3: 100uf; E2,5-7
C8, C11: 22uf; E2,5-7
IC2: 7805; TO-220-ALT
IC3: AZ1117; 78XXL
L1: 100uH; TFI0307
L2, L3: 100uH; 0207/7
LED1: ROJO; LED3MM
LED2: VERDE; LED3MM
R1: 2k2; 0204/5
R2: 680; 0204/5
S1: SWITCH; TL3XYO
U$9: 10W 5R6J; RES-49X10

Connections:
+3V3: C9.1, L3.1, LED2.A; also elsewhere on the board
+11V1: S1.3 (S); also elsewhere on the board
unnamed: C1.1, C2.+, L1.1, S1.2
unnamed: C5.1, IC2.IN, U$9.P$2
unnamed: C3.+, C4.1, L1.2, U$9.P$1
unnamed: C7.1, C8.+, IC2.OUT, IC3.OUT (IN), L2.2
unnamed: LED1.K (C), R1.1
unnamed: C10.1, C11.+, IC3.GND (OUT), L3.2
unnamed: LED2.K (C), R2.1
VDD: C6.1, L2.1, LED1.A; also elsewhere on the board
VSS: C1.2, C2.-, C3.-, C4.2, C5.2, C6.2, C7.2, C8.-, C9.2, C10.2, C11.-, IC2.GND, IC3.IN (GND), R1.2, R2.2; also elsewhere on the board

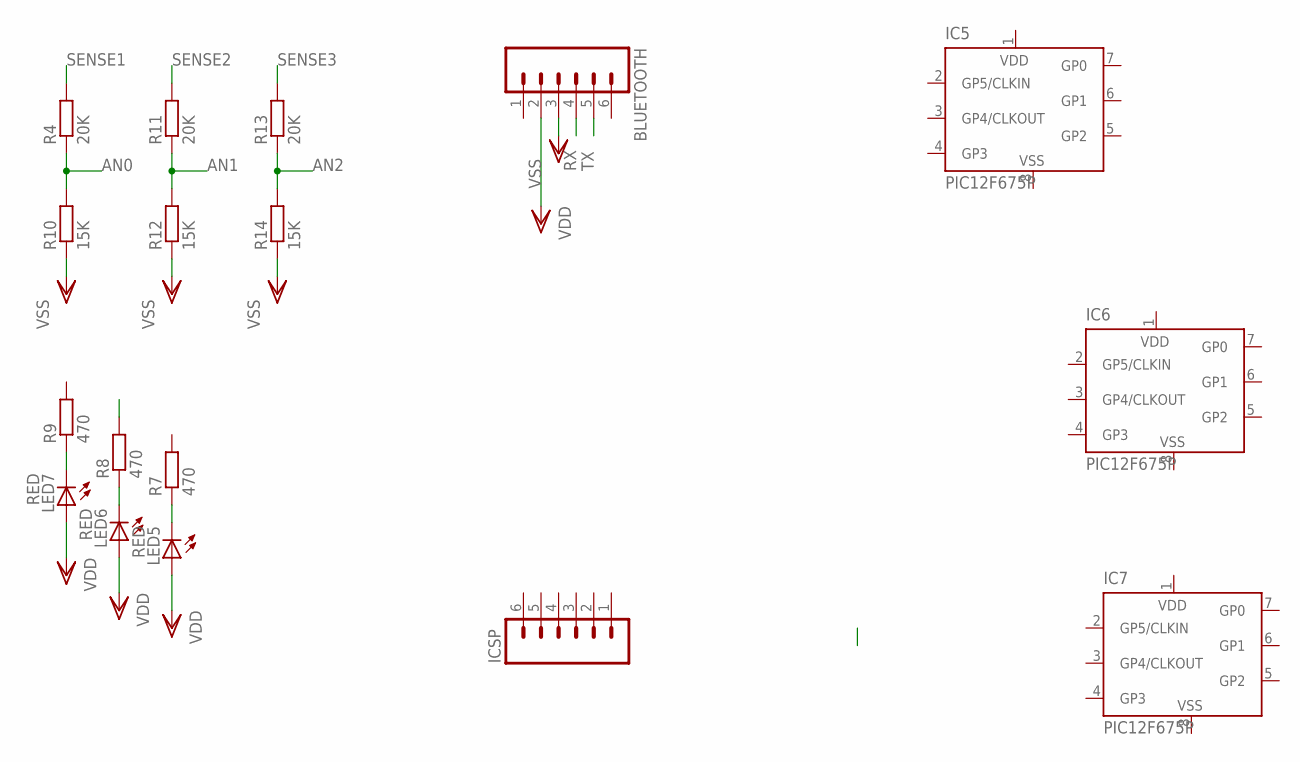
[picture p92: schematic energia-2.sch, sheet 4, Monitor Lipo]

Parts:
BLUETOOTH: 1X06_LONGPADS
IC5, IC6, IC7: PIC12F675P; DIL8
ICSP: 1X06_LONGPADS
LED5, LED6, LED7: RED; LED3MM
R4, R11, R13: 20K; 0204/5
R7, R8, R9: 470; 0204/5
R10, R12, R14: 15K; 0204/5

Connections:
AN0: R4.1, R10.2
AN1: R11.1, R12.2
AN2: R13.1, R14.2
unnamed: LED5.K (C), R7.1
unnamed: LED7.K (C), R9.1
unnamed: LED6.K (C), R8.1
RX: BLUETOOTH.4
SENSE1: R4.2; also elsewhere on the board
SENSE2: R11.2; also elsewhere on the board
SENSE3: R13.2; also elsewhere on the board
TX: BLUETOOTH.5
VDD: BLUETOOTH.2, IC5.1 (VDD), IC6.1 (VDD), IC7.1 (VDD), LED5.A, LED6.A, LED7.A; also elsewhere on the board
VSS: BLUETOOTH.3, IC5.8 (VSS), IC6.8 (VSS), IC7.8 (VSS), R10.1, R12.1, R14.1; also elsewhere on the board

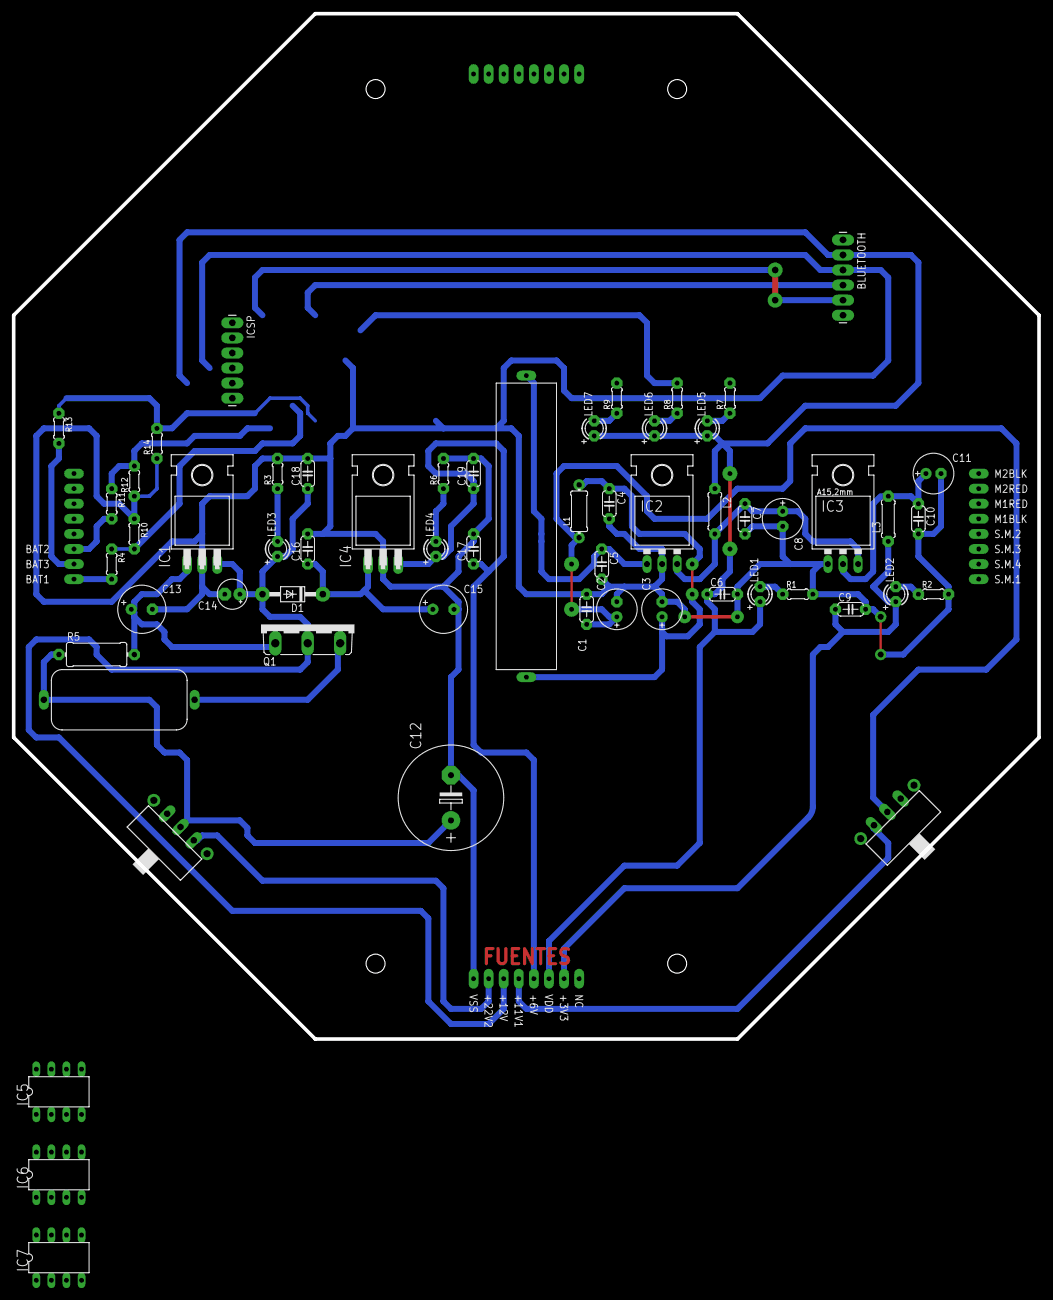
[picture p93: board energia-2.brd from above]

Board: 2 copper layers, 172.7 x 172.7 mm, 59 parts (0 on the bottom side), 29 nets.
