aasanchez/Trabajo-de-Grado/Eagle/TG-Final/nivel0-2.brd

## EAGLE design Eagle/TG-Final/nivel0-2.brd (2012-04-04)

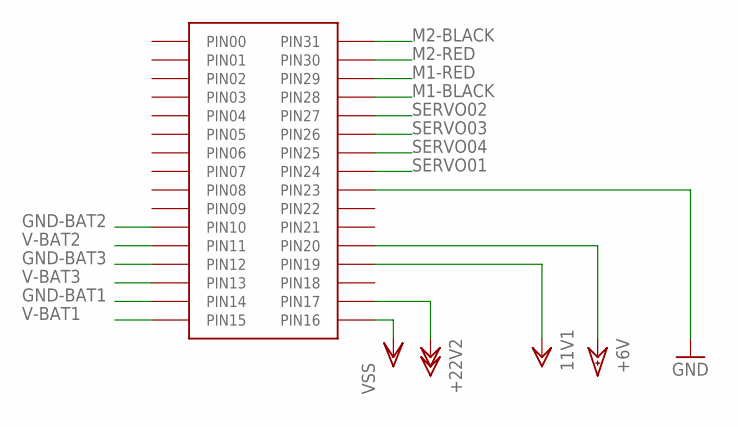
[picture p94: schematic nivel0-2.sch, sheet 1, Base]

Parts:
U$1: BASE

Connections:
+6V: U$1.PIN20; also elsewhere on the board
+11V1: U$1.PIN19; also elsewhere on the board
+22V: U$1.PIN17; also elsewhere on the board
GND: U$1.PIN23; also elsewhere on the board
GND-BAT1: U$1.PIN14; also elsewhere on the board
GND-BAT2: U$1.PIN10; also elsewhere on the board
GND-BAT3: U$1.PIN12; also elsewhere on the board
M1-BLACK: U$1.PIN28; also elsewhere on the board
M1-RED: U$1.PIN29; also elsewhere on the board
M2-BLACK: U$1.PIN31; also elsewhere on the board
M2-RED: U$1.PIN30; also elsewhere on the board
SERVO01: U$1.PIN24; also elsewhere on the board
SERVO02: U$1.PIN27; also elsewhere on the board
SERVO03: U$1.PIN26; also elsewhere on the board
SERVO04: U$1.PIN25; also elsewhere on the board
V-BAT1: U$1.PIN15; also elsewhere on the board
V-BAT2: U$1.PIN11; also elsewhere on the board
V-BAT3: U$1.PIN13; also elsewhere on the board
VSS: U$1.PIN16; also elsewhere on the board

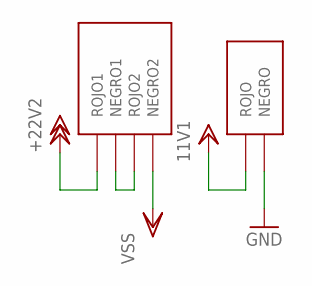
[picture p95: schematic nivel0-2.sch, sheet 2, Alimentación]

Parts:
U$11: CONECTOR_AUDIO
U$12: CONECTOR_AUDIO2

Connections:
+11V1: U$12.P$2 (ROJO); also elsewhere on the board
+22V: U$11.P$1 (ROJO1); also elsewhere on the board
GND: U$12.P$1 (NEGRO); also elsewhere on the board
unnamed: U$11.P$2 (NEGRO1), U$11.P$3 (ROJO2)
VSS: U$11.P$4 (NEGRO2); also elsewhere on the board

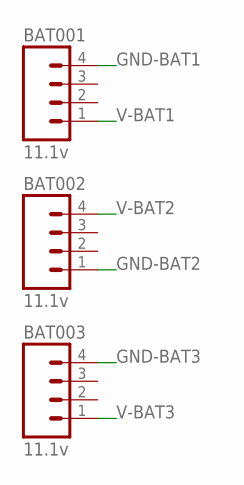
[picture p96: schematic nivel0-2.sch, sheet 3, Monitor Baterias]

Parts:
BAT001, BAT002, BAT003: 11.1v; 1X04_LONGPADS

Connections:
GND-BAT1: BAT001.4; also elsewhere on the board
GND-BAT2: BAT002.1; also elsewhere on the board
GND-BAT3: BAT003.4; also elsewhere on the board
V-BAT1: BAT001.1; also elsewhere on the board
V-BAT2: BAT002.4; also elsewhere on the board
V-BAT3: BAT003.1; also elsewhere on the board
