aasanchez/Trabajo-de-Grado/Eagle/TG-Final/nivel0-2.brd

## EAGLE design Eagle/TG-Final/nivel0-2.brd (continued)

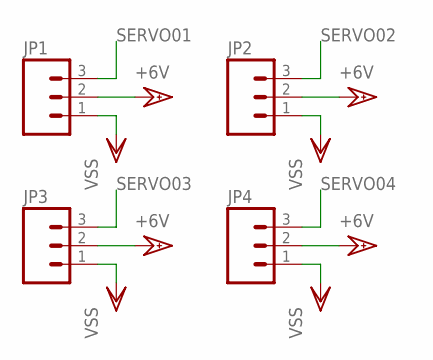
[picture p97: schematic nivel0-2.sch, sheet 4, Servo Connection]

Parts:
JP1, JP2, JP3, JP4: 1X03_LONGPADS

Connections:
+6V: JP1.2, JP2.2, JP3.2, JP4.2; also elsewhere on the board
SERVO01: JP1.3; also elsewhere on the board
SERVO02: JP2.3; also elsewhere on the board
SERVO03: JP3.3; also elsewhere on the board
SERVO04: JP4.3; also elsewhere on the board
VSS: JP1.1, JP2.1, JP3.1, JP4.1; also elsewhere on the board

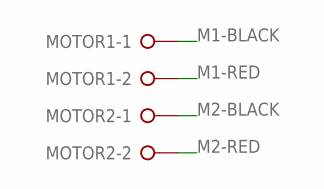
[picture p98: schematic nivel0-2.sch, sheet 5, MOTOR CONNECTION]

Parts:
MOTOR1, MOTOR2: W237-132

Connections:
M1-BLACK: MOTOR1.1; also elsewhere on the board
M1-RED: MOTOR1.2; also elsewhere on the board
M2-BLACK: MOTOR2.1; also elsewhere on the board
M2-RED: MOTOR2.2; also elsewhere on the board

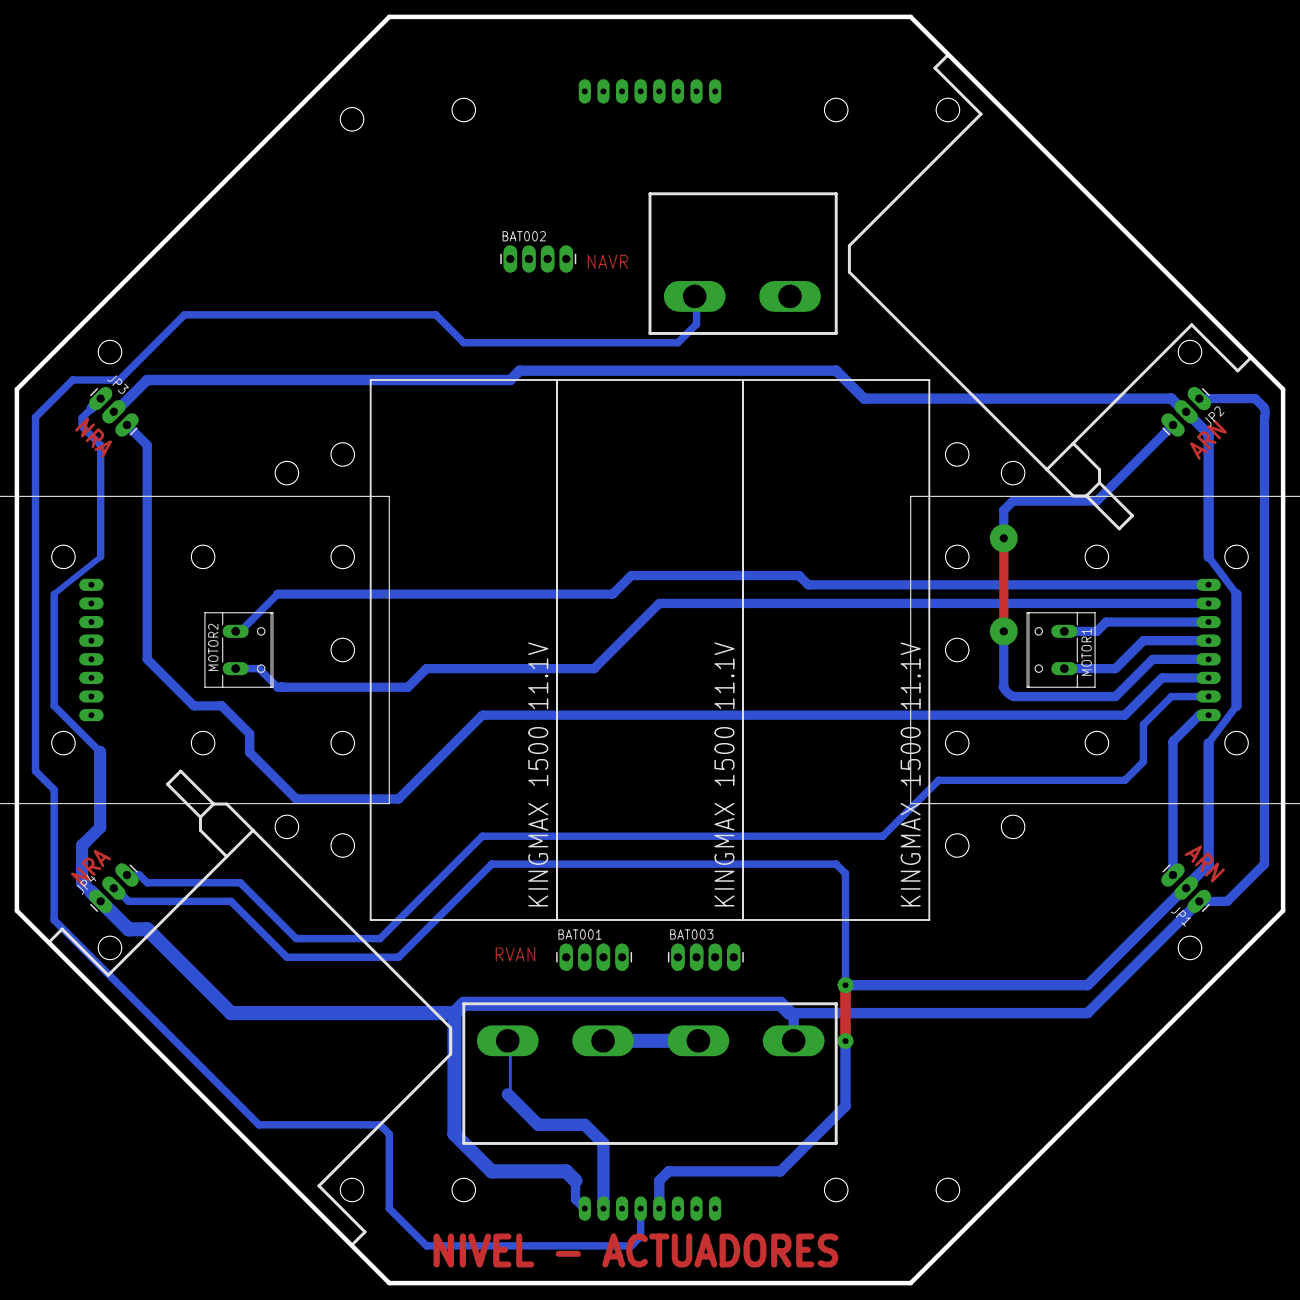
[picture p99: board nivel0-2.brd from above]

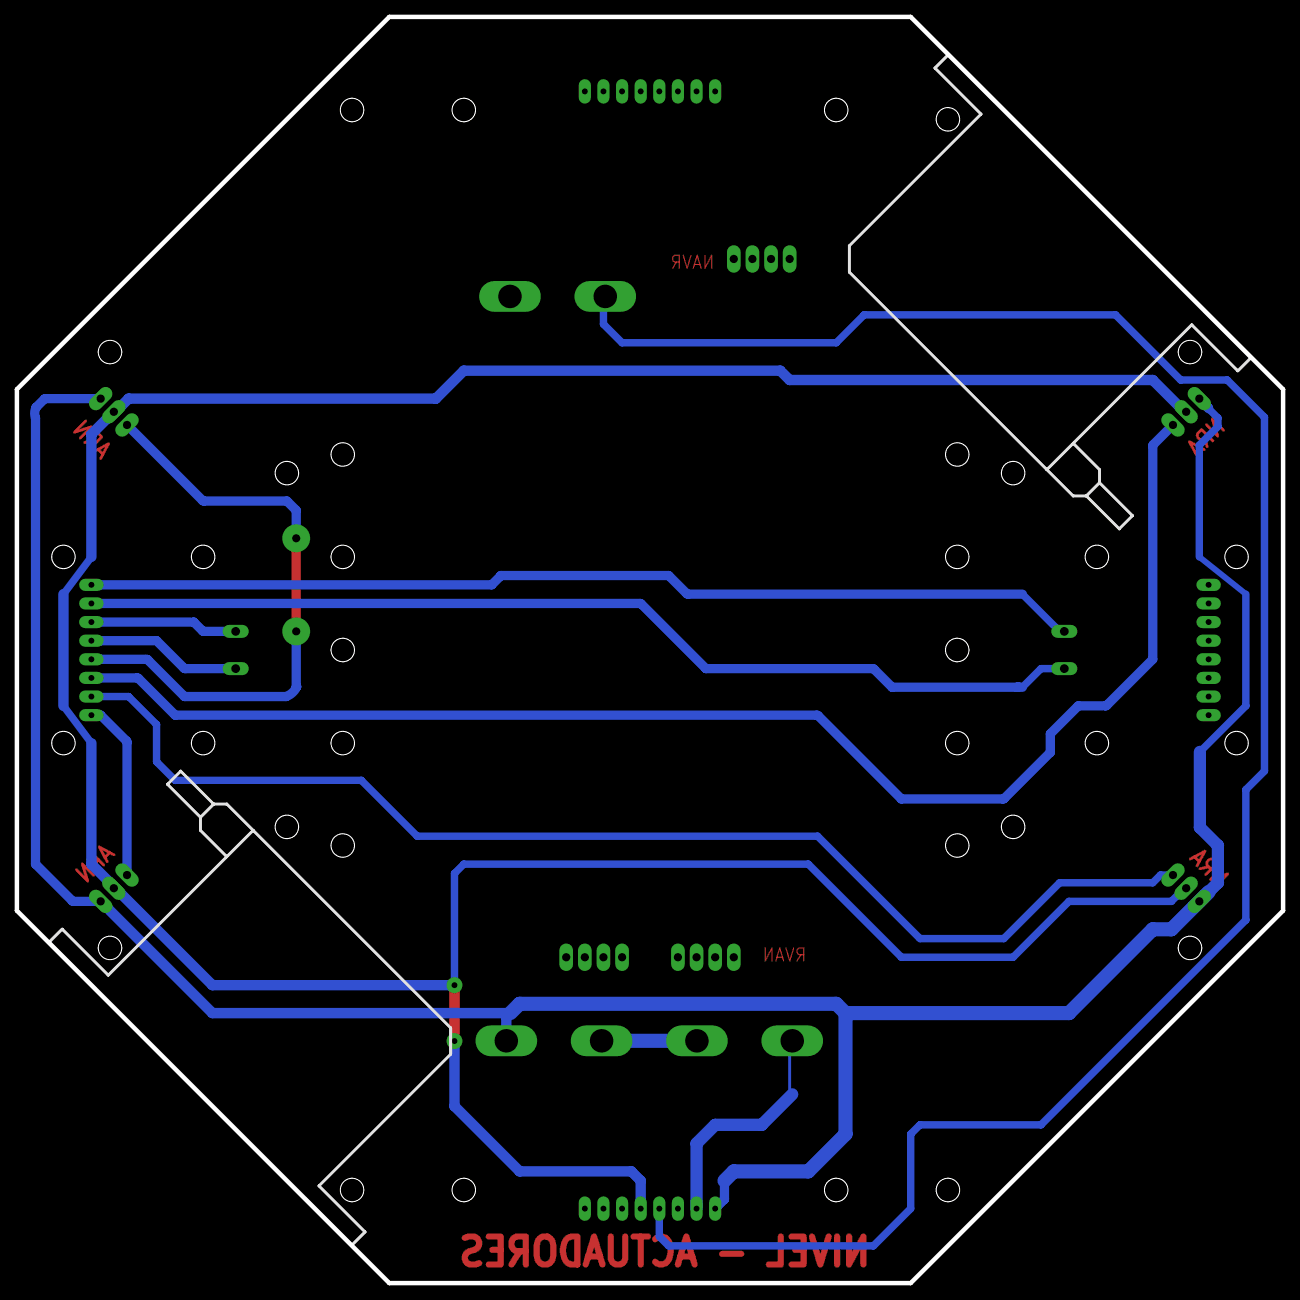
[picture p100: board nivel0-2.brd from below]

Board: 2 copper layers, 172.7 x 172.7 mm, 21 parts (2 on the bottom side), 20 nets.

Other parts of the board:
U$2, U$3, U$4: KINGMAX1500
U$5, U$6: BASEMOTOR
U$7, U$8, U$9, U$10: SERVOBODY
