aasanchez/Trabajo-de-Grado/Eagle/TG-Final/control.brd

## EAGLE design Eagle/TG-Final/control.brd (2012-03-31)

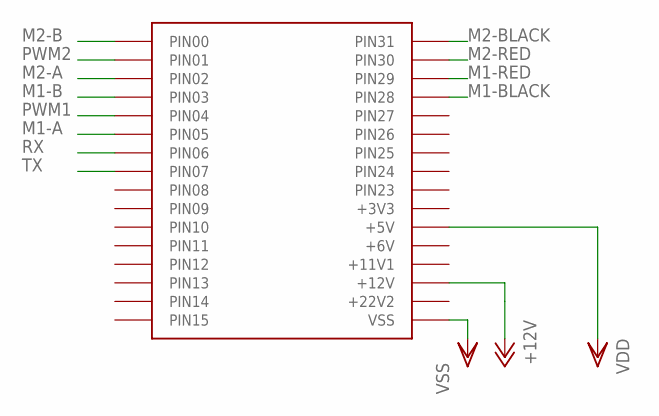
[picture p101: schematic control.sch, sheet 1]

Parts:
U$1: BASE

Connections:
+12V: U$1.PIN18 (+12V); also elsewhere on the board
M1-A: U$1.PIN05; also elsewhere on the board
M1-B: U$1.PIN03; also elsewhere on the board
M1-BLACK: U$1.PIN28; also elsewhere on the board
M1-RED: U$1.PIN29; also elsewhere on the board
M2-A: U$1.PIN02; also elsewhere on the board
M2-B: U$1.PIN00; also elsewhere on the board
M2-BLACK: U$1.PIN31; also elsewhere on the board
M2-RED: U$1.PIN30; also elsewhere on the board
PWM1: U$1.PIN04; also elsewhere on the board
PWM2: U$1.PIN01; also elsewhere on the board
RX: U$1.PIN06; also elsewhere on the board
TX: U$1.PIN07; also elsewhere on the board
VDD: U$1.PIN21 (+5V); also elsewhere on the board
VSS: U$1.PIN16 (VSS); also elsewhere on the board

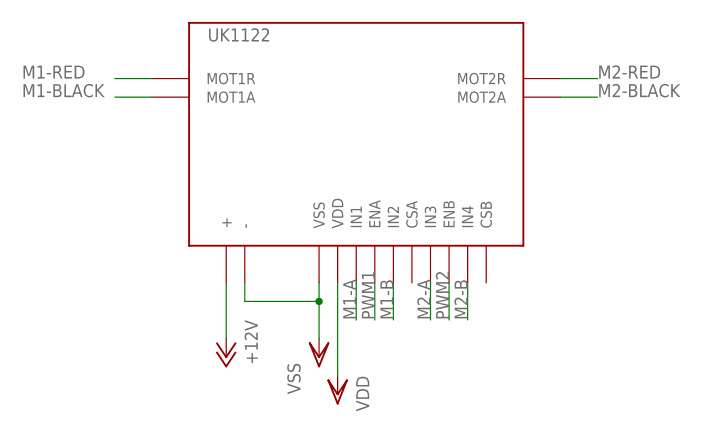
[picture p102: schematic control.sch, sheet 2]

Parts:
UK1122: UK1122

Connections:
+12V: UK1122.+; also elsewhere on the board
M1-A: UK1122.IN1; also elsewhere on the board
M1-B: UK1122.EN2 (IN2); also elsewhere on the board
M1-BLACK: UK1122.MOT1A; also elsewhere on the board
M1-RED: UK1122.MOT1R; also elsewhere on the board
M2-A: UK1122.IN3; also elsewhere on the board
M2-B: UK1122.IN4; also elsewhere on the board
M2-BLACK: UK1122.MOT2A; also elsewhere on the board
M2-RED: UK1122.MOT2R; also elsewhere on the board
PWM1: UK1122.ENA; also elsewhere on the board
PWM2: UK1122.ENB; also elsewhere on the board
VDD: UK1122.+5 (VDD); also elsewhere on the board
VSS: UK1122.-, UK1122.GND (VSS); also elsewhere on the board

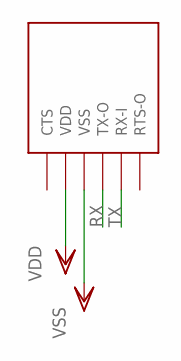
[picture p103: schematic control.sch, sheet 3]

Parts:
U$3: BLUESMIRF

Connections:
RX: U$3.TX-O; also elsewhere on the board
TX: U$3.RX-I; also elsewhere on the board
VDD: U$3.VDD; also elsewhere on the board
VSS: U$3.VSS; also elsewhere on the board

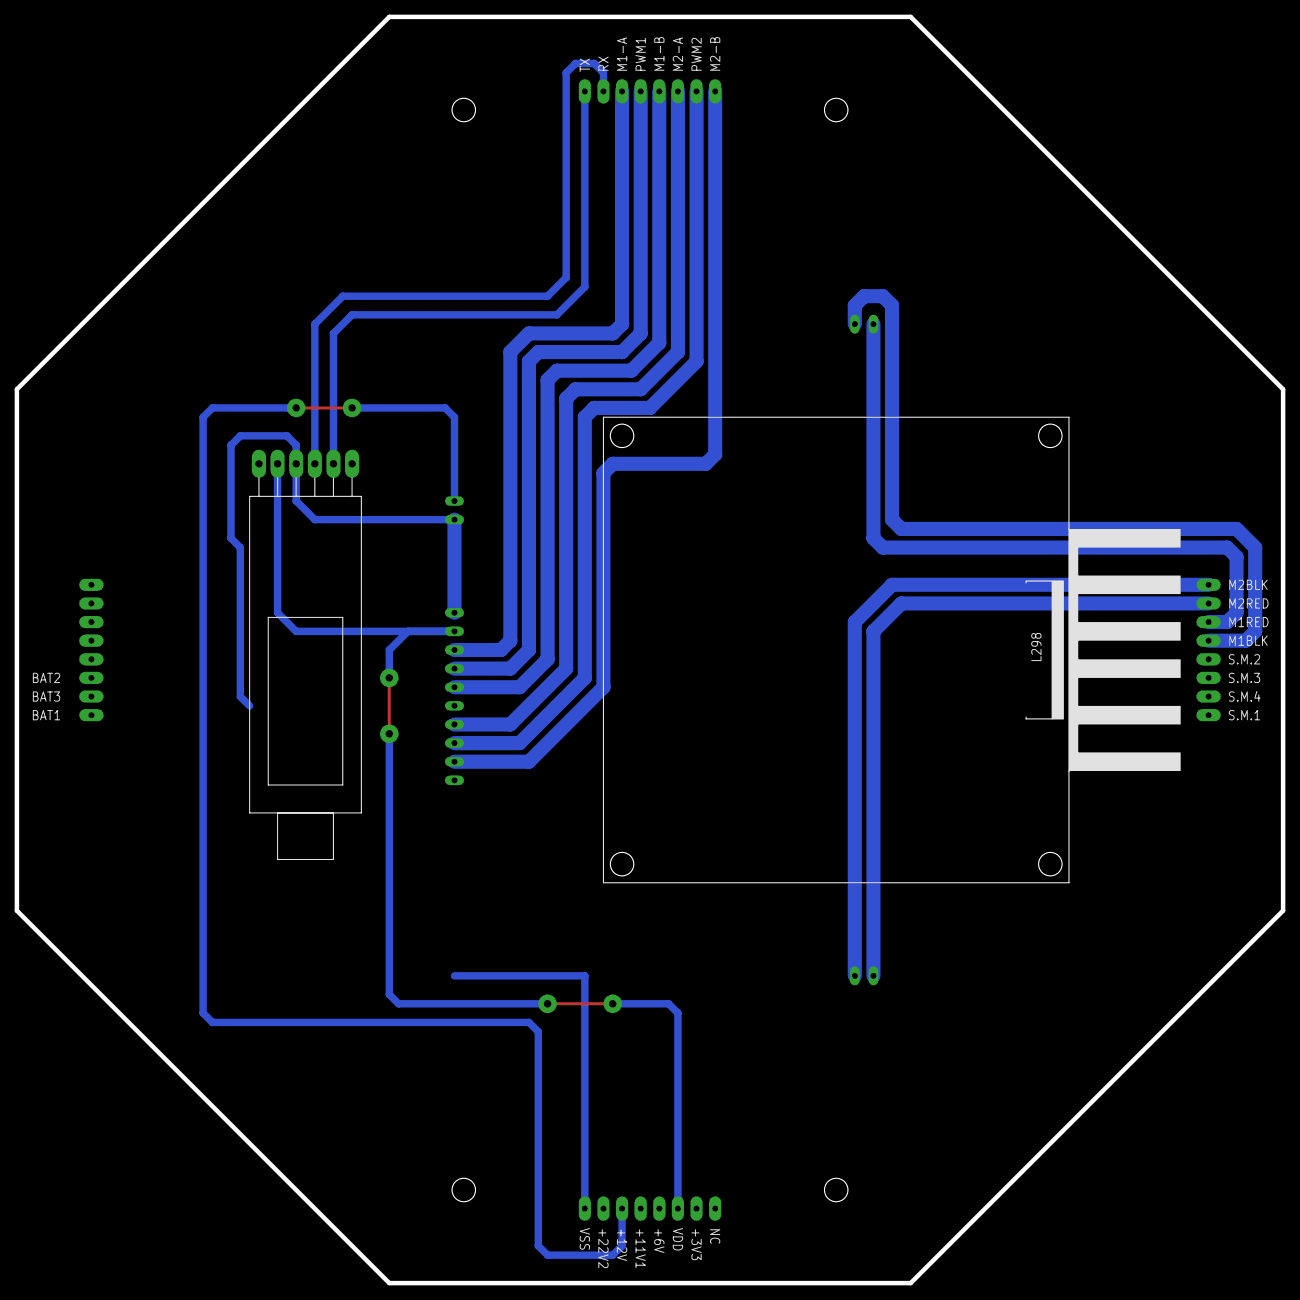
[picture p104: board control.brd from above]

Board: 2 copper layers, 172.7 x 172.7 mm, 3 parts (0 on the bottom side), 15 nets.
