aasanchez/Trabajo-de-Grado/Eagle/TG-Final/potencia.brd

## EAGLE design Eagle/TG-Final/potencia.brd (2012-03-08)

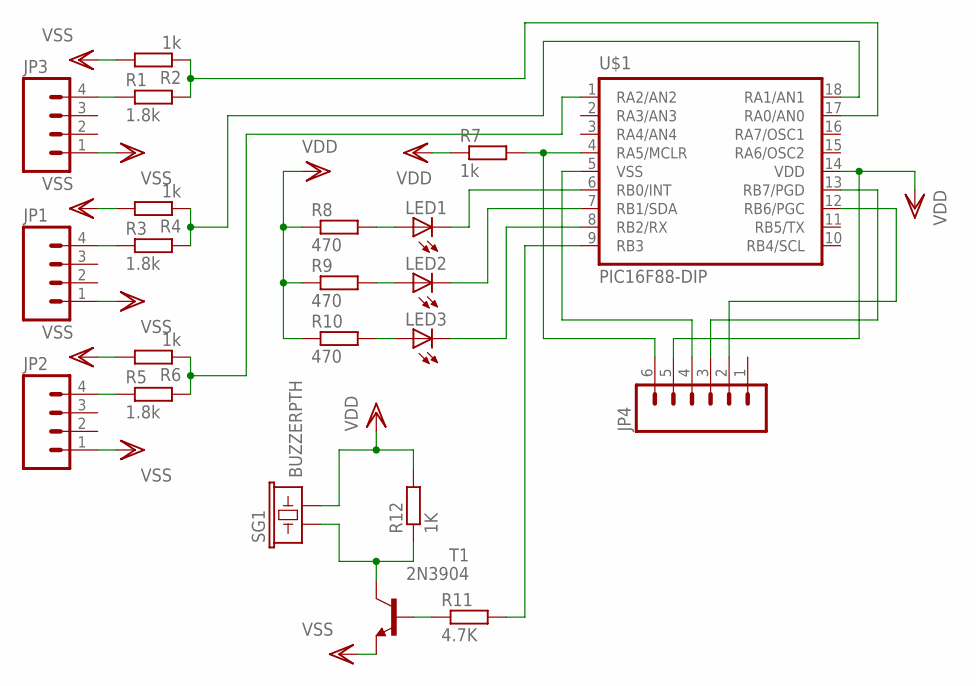
[picture p105: schematic potencia.sch, sheet 1, Monitor Bateria]

Parts:
JP1, JP2, JP3: M04LONGPADS; 1X04_LONGPADS
JP4: M06LONGPADS; 1X06_LONGPADS
LED1, LED2, LED3: LED3MM
R1, R3, R5: 1.8k; 0204/5
R2, R4, R6, R7: 1k; 0204/5
R8, R9, R10: 470; 0204/5
R11: 4.7K; 0204/5
R12: 1K; 0204/5
SG1: BUZZERPTH; BUZZER-12MM
T1: 2N3904; TO92
U$1: PIC16F88-DIP; DIL18

Connections:
unnamed: JP3.4, R1.1
unnamed: R1.2, R2.1, U$1.17 (RA0/AN0)
unnamed: JP1.4, R3.1
unnamed: R3.2, R4.1, U$1.18 (RA1/AN1)
unnamed: JP2.4, R5.1
unnamed: R5.2, R6.1, U$1.1 (RA2/AN2)
unnamed: JP4.4, U$1.5 (VSS)
unnamed: LED1.K (C), U$1.6 (RB0/INT)
unnamed: LED2.K (C), U$1.7 (RB1/SDA)
unnamed: LED3.K (C), U$1.8 (RB2/RX)
unnamed: LED1.A, R8.2
unnamed: JP4.3, U$1.13 (RB7/PGD)
unnamed: LED2.A, R9.2
unnamed: LED3.A, R10.2
unnamed: JP4.2, U$1.12 (RB6/PGC)
unnamed: JP4.6, R7.2, U$1.4 (RA5/MCLR)
unnamed: R11.2, U$1.9 (RB3)
unnamed: R11.1, T1.2 (B)
unnamed: R12.1, SG1.+ (1), T1.1 (C)
VDD: JP4.5, R7.1, R8.1, R9.1, R10.1, R12.2, SG1.- (2), U$1.14 (VDD)
VSS: JP1.1, JP2.1, JP3.1, R2.2, R4.2, R6.2, T1.3 (E); also elsewhere on the board

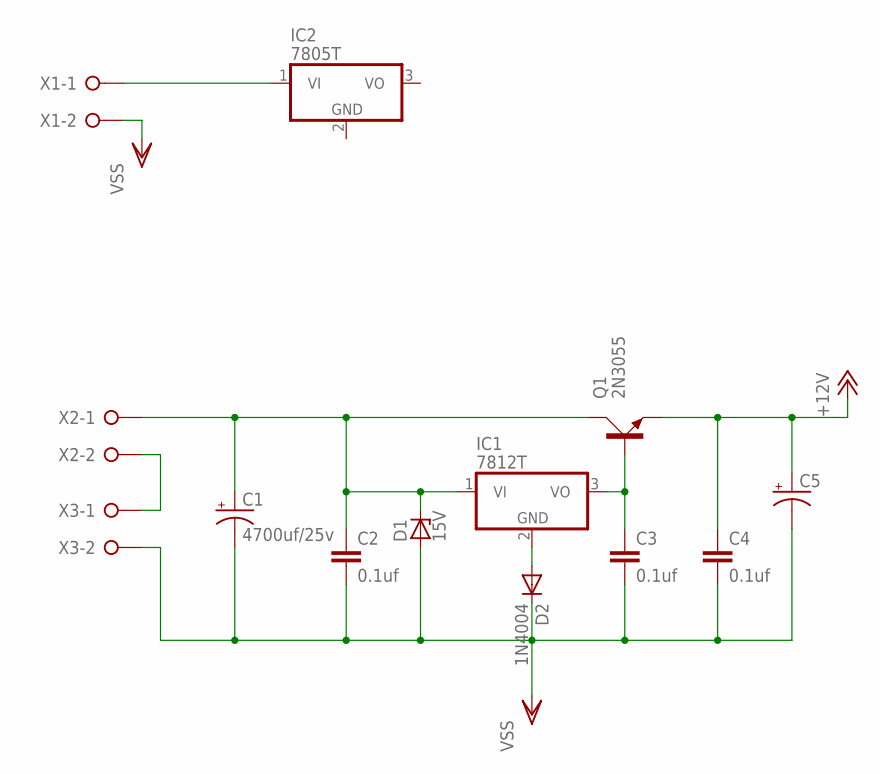
[picture p106: schematic potencia.sch, sheet 2, Regulación de Voltaje]

Parts:
C1: 4700uf/25v; EB30D
C2, C3, C4: 0.1uf; C050-024X044
C5: CPOL-USE2.5-6; E2,5-6
D1: 15V; F126Z10
D2: 1N4004; DO41-10
IC1: 7812T; TO220H
IC2: 7805T; TO220H
Q1: 2N3055; TO3A
X1, X2, X3: W237-2N

Connections:
+12V: C4.1, C5.+, Q1.E
unnamed: X2.2, X3.1
unnamed: C1.+, C2.1, D1.C, IC1.1 (VI), Q1.C, Q1.C1 (C), X2.1
unnamed: C3.1, IC1.3 (VO), Q1.B
unnamed: IC2.1 (VI), X1.1
unnamed: D2.A, IC1.2 (GND)
VSS: C1.-, C2.2, C3.2, C4.2, C5.-, D1.A, D2.C, X1.2, X3.2; also elsewhere on the board

Board: 2 copper layers, 35 parts (0 on the bottom side), 27 nets, no tracks yet.
