aasanchez/Trabajo-de-Grado/Eagle/TG-Final/logica.brd

## EAGLE design Eagle/TG-Final/logica.brd (2012-03-08)

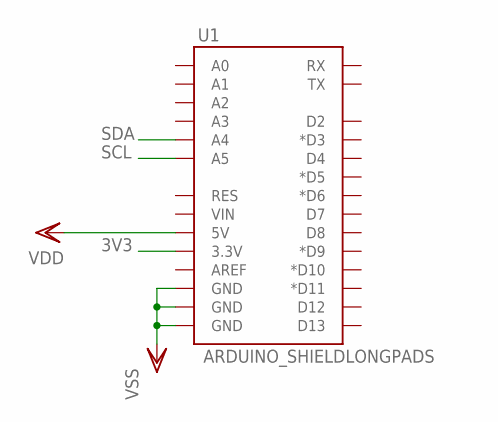
[picture p107: schematic logica.sch, sheet 1, Arduino]

Parts:
U1: ARDUINO_SHIELDLONGPADS; DUEMILANOVE_SHIELD_LONGPADS

Connections:
3V3: U1.3.3V; also elsewhere on the board
SCL: U1.A5; also elsewhere on the board
SDA: U1.A4; also elsewhere on the board
VDD: U1.5V; also elsewhere on the board
VSS: U1.GND@0 (GND), U1.GND@1 (GND), U1.GND@2 (GND); also elsewhere on the board

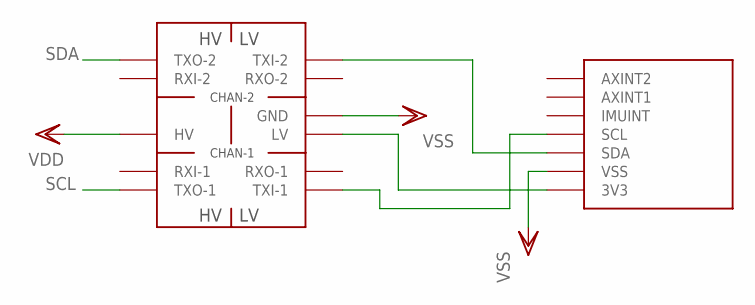
[picture p108: schematic logica.sch, sheet 2, IMU300 Combo]

Parts:
U$1: LOGIC-LEVEL-CONVERTER; LEVEL-CONVERTER
U$2: IMU3000COMBO; IMU3000-COMBO

Connections:
: U$1.P$9
3V3: U$1.P$3 (LV), U$2.3V3; also elsewhere on the board
unnamed: U$1.P$1 (TXI-1), U$2.SCL
unnamed: U$1.P$6 (TXI-2), U$2.SDA
SCL: U$1.P$12 (TXO-1); also elsewhere on the board
SDA: U$1.P$7 (TXO-2); also elsewhere on the board
VDD: U$1.P$10 (HV); also elsewhere on the board
VSS: U$1.P$4 (GND), U$2.VSS; also elsewhere on the board

Board: 2 copper layers, 3 parts (0 on the bottom side), 7 nets, no tracks yet.
