aasanchez/Trabajo-de-Grado/(commit log)

2011-11-10 Lista de Compras
2012-02-13 Limpieza Profunda
    [imu300_combo_board-v10.brd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]
2012-02-15 Codigo para graficas señales cortesia de Yeison Cardona
2012-02-16 Monitor Lipo
    [simulador.DSN]
2012-02-16 Lectura 3 canales monitor de baterias
2012-02-16 Salidas en led alarma lipo
    [simulador.DSN]
2012-02-16 Listo Codigo monitoreo Lipo 16f88
    [simulador.DSN]
2012-02-16 inicio comunicacion CDC
    [Mainboard.sch]
2012-02-16 Graficas de IMU
2012-02-20 Inicio de Codigo Final
2012-02-20 Intento obtener datos del imu e una funcion
2012-02-22 Calibracion de Sensores
2012-02-22 Lectura y Optimizacion de Codigo
2012-02-23 Correccion para ADXL345 Eje Z, y graficas separadas
2012-03-01 Run Led
    [untitled.brd, untitled.sch]
2012-03-02 Adquisición de sensores, limpieza de ruido y de calculo de zero, el cálculo del ángulo
2012-03-02 Filtro de Kalman
2012-03-02 iniciando de 298
2012-03-02 Fix Pin l298
2012-03-05 Comienzo de Control para Muñeco de Madera
2012-03-07 Diseño CAD y otros
    [DISEÑO.DWG, potencia.sch]
2012-03-07 Schematic para Potencia
    [potencia.brd, potencia.sch]
2012-03-08 Esquematicos de Alimentación
    [logica.sch, potencia.sch]
2012-03-08 Esquematicos para placa logica
    [logica.brd, logica.sch, potencia.brd, potencia.sch]
2012-03-08 Fix Pins Motor 1, Avances en Esquematicos
    [logica.sch]
2012-03-14 Placa de Actuadores y Otros
    [logica.sch, nivel0.brd, nivel0.sch]
2012-03-14 Routing placa Actuadores
    [nivel0.brd, nivel0.sch]
2012-03-14 Routing placa Actuadores. Listo??
    [nivel0.brd, nivel0.sch]
2012-03-15 Mejoras en placa de Actuadores y otros
    [energia.sch, nivel0.brd, nivel0.sch]
2012-03-16 Comienzo placa potencia
    [energia.brd, energia.sch]
2012-03-19 Fuente 11.1v -> 5v y 3v3
    [energia.brd, energia.sch, nivel0.brd]
2012-03-19 Monitor Baterias LiPO
    [energia.brd, energia.sch, nivel0.brd, nivel0.sch]
2012-03-23 Fuente de Potencia
    [energia.brd, energia.sch]
2012-03-25 Trabajos en la Sub Estacion
    [energia.brd, energia.sch, nivel0.brd]
2012-03-25 Reposicionando componentes en SubEstación
    [energia.brd]
2012-03-26 Pruebas del Monitor de Baterias Lipo
    [energia.brd, energia.sch, simulador.DSN]
2012-03-28 Peliando con un 16f88
    [brain.sch, energia.brd, energia.sch, simulador.DSN]
2012-03-28 Sonido de alarma bajo Voltaje
    [simulador.DSN]
2012-03-28 Barrido leds alarma
2012-03-29 Alias a algunas funciones monitor baterias lipo
2012-03-29 Lecturas Analogicas, problemas en resolución Aun
    [simulador.DSN]
2012-03-29 Listo Monitor de 1 Bateria
    [simulador.DSN]
2012-03-29 Completado Monitor de Bateria
2012-03-29 Placa Sub-Estación. Lista
    [energia.brd, energia.sch, simulador.DSN]
2012-03-30 Placa de Control Motores y Comunicación
    [brain.brd, brain.sch, control.brd, control.sch, energia.brd, energia.sch]
2012-03-31 Listo Placas
    [brain.brd, brain.sch, control.brd, control.sch, energia.brd]
2012-04-04 Actualizaciones Varias
    [brain.brd, brain.sch, nivel0-2.brd, nivel0-2.sch]
2012-04-08 Limpieza de Archivos Viejos
    [simulador.DSN]
2012-04-09 Diagrama de Procesos
2012-04-09 Diagrama de Procesos General
2012-04-09 Avanzando con los Graficos
    [Esquematico.fzz, l298.sch]
2012-04-10 Pruebas Movimiento 1 Motor
2012-04-11 Fix: Polaridad Motores
2012-04-11 Fix: Pines PWM
2012-04-12 Pruebas lectura IMU3000 Combo
2012-04-13 Limpieza de cosas que ya no van
    [DISEÑO.DWG]
2012-04-15 Nuevo diseño
    [Motores.brd, Motores.sch, arduino.brd, arduino.sch, brain.brd, uk1122.brd, uk1122.sch]
2012-04-16 Haciendo el Informe
    [Motores.brd]
2012-04-18 Siento que la vida se me va en cada tecla... la redaccion es horrible
2012-04-23 Muchos Cambios a 2 dias de la denfesa
    [Motores.brd, Motores.sch, Print.brd, arduino.brd, arduino.sch, bluesmirf.brd, bluesmirf.sch, uk1122.brd]
